AlephInfi/PRISTA/PRISTA design.docx

PRISTA design

1. Requirements were defined
  a. Course of one month, laying out structural considerations, integration limits, mission objectives.
  b. Mission objectives:
    i. Validate inter-board communication using UART and SPI (stacked) as well as RS485 (at distance).
    ii. Diagnose early issues on a low-cost board before higher-expense boards are manufactured.
  c. Mission statement:
    i. The primary mission is to catch, debug, and resolve issues arising from new board architectures before they are encountered in a time-sensitive project.
2. KiCAD design began after requirements definition.
  a. Requirements changed over time due to constraints and trade research encountered in PCB design
    i. Magnetometer switched to MMC5983MA, as the 5883 was not available. 5983 is the industrial version rated for higher temperatures and with SPI support.
