AlephInfi/PRISTA/main/jlcpcb/production_files/BOM-main.csv

Comment | Designator | Footprint | LCSC | Quantity
10 | R13 | R_0603_1608Metric | C22859 | 1
100 | R11,R12,R2,R3 | R_0603_1608Metric | C22775 | 4
100k | R1 | R_0603_1608Metric | C25803 | 1
100n | C10,C12,C14,C17,C19,C2,C20,C22,C23,C26,C27,C28,C29,C3,C30,C31,C35,C36,C38,C39,C4,C40,C42,C46,C5,C6,C9 | C_0603_1608Metric | C14663 | 27
10k | R10,R18,R19,R20,R4,R5,R9 | R_0603_1608Metric | C25804 | 7
10k | RN1 | R_Array_Convex_4x0603 | C29718 | 1
10n | C43 | C_0603_1608Metric | C57112 | 1
10p | C47,C48,C49,C50,C51,C52 | C_0603_1608Metric | C1634 | 6
10u | C24,C37,C41 | C_0603_1608Metric | C19702 | 3
10u 25V | C16 | C_0805_2012Metric | C15850 | 1
16MHz | U10,U11,U6 | Crystal_SMD_3225-4Pin_3.2x2.5mm | C13738 | 3
1k | R14,R15,R8 | R_0603_1608Metric | C21190 | 3
1u | C13,C25,C7,C8 | C_0603_1608Metric | C15849 | 4
2.2u | C44,C45 | C_0603_1608Metric | C23630 | 2
2.7k | R6,R7 | R_0603_1608Metric | C13167 | 2
22 | R21,R22,R23 | R_0603_1608Metric | C23345 | 3
22u | C18,C21 | C_0603_1608Metric | C59461 | 2
27n | L2 | L_0603_1608Metric | C12669 | 1
4.7k | R16,R17 | R_0603_1608Metric | C23162 | 2
4.7u | L1 | L_6.3x6.3_H3 | C128688 | 1
4.7u | C1,C11,C15 | C_0603_1608Metric | C19666 | 3
AO3401A | Q1 | SOT-23 | C15127 | 1
AP63203WU | U4 | TSOT-23-6 | C780769 | 1
BMI323 | U12 | BMI323_BOS | C5368700 | 1
LED red | D1,D2,D3 | LED_0805_2012Metric | C84256 | 3
LSM6DSL | U2 | LGA-14_3x2.5mm_P0.5mm_LayoutBorder3x4y | C126672 | 1
MMC5983MA | U3 | LGA-16_3x3mm_P0.5mm | C404329 | 1
Micro_SD_Card_Det1 | J1 | microSD_HC_Molex_47219-2001 | C164170 | 1
SP3485EN | U5,U9 | SOIC-8_3.9x4.9mm_P1.27mm | C8963 | 2
STM32F405RGTx | U1 | LQFP-64_10x10mm_P0.5mm | C15742 | 1
STM32G071CBT6 | U7,U8 | LQFP-48_7x7mm_P0.5mm | C432212 | 2
