AlephInfi/PRISTA/SW_Timing_Budgets.xlsx

Sheet: SW_Timing_Budgets
CTRL-F Payload 2026 · Software timing budget
Board 1 STM32F405 (LSM6DSL, MMC5983MA, microSD, RS-485) · Board 2 STM32G071 (BMI323, stacked) · Board 3 STM32G071 (MAX-M10S GPS, RS-485). Peripheral/pin assignments taken from the three .ioc files; change a cell here and every rate, DMA check and timeline downstream recomputes.
Legend: blue text = input you edit · yellow fill = key lever · black = formula · green = pulled from another sheet · status cells turn red/amber when a limit is broken.
1 · Global loop inputs
Target loop rate |  |  | 1000 | Hz | Requirement: ≥100 Hz minimum, 1 kHz target (one sample + analysis per sensor per cycle). Every per-cycle number scales from this.
Minimum loop rate |  |  | 100 | Hz | Stated requirement floor.
Loop period |  |  | 1000.0 | µs | Time available per cycle.
Max bus utilization allowed |  |  | 60.0% |  | Headroom for retries, jitter and growth. Buses above this turn red on Interface_Data_Rates.
Max CPU utilization allowed |  |  | 70.0% |  | Leave ≥30% for ISR jitter, logging stalls and future code.
Magnetometer ODR (MMC5983MA) |  |  | 1000 | Hz | 1 kHz needs continuous mode with BW=11 (0.5 ms measurement). BW=00 is ~8 ms → ≤100 Hz.
GPS navigation rate (MAX-M10S) |  |  | 10 | Hz | Default config (GPS+GAL+BDS B1I) is 3 Hz max; GPS+GAL allows 10 Hz; single-GNSS 18 Hz (MAX-M10S datasheet Tables 2–3).
SDIO kernel clock (PLL Q) |  |  | 48.000 | MHz | F405: PLLM 16, PLLN 192, PLLQ 4 from the 16 MHz HSE (as set in the fixed .ioc).
Loop target meets minimum? |  |  | OK
2 · Clock tree per MCU (edit SYSCLK and dividers; all bus/timer clocks follow)
Board | MCU | Clock source | HSE (MHz) | SYSCLK (MHz) | AHB ÷ | APB1 ÷ | APB2 ÷ | HCLK (MHz) | PCLK1 (MHz) | PCLK2 (MHz) | TIMCLK1 (MHz) | TIMCLK2 (MHz) | SYSCLK max | APB1 max | APB2 max | Status | Notes
B1 | STM32F405RG | HSE 16 MHz xtal | 16.000 | 16.000 | 1 | 1 | 1 | 16.000 | 16.000 | 16.000 | 16.000 | 16.000 | 168.000 | 42.000 | 84.000 | OK | As built: SYSCLK = HSE 16 MHz (PLL only feeds SDIO 48 MHz). For 168 MHz set SYSCLK 168, APB1 ÷4, APB2 ÷2 (PLLM16 N336 P2 Q7), then re-check SPI2 prescaler (LSM6DSL ≤10 MHz) below.
B2 | STM32G071CB | HSE 16 MHz xtal | 16.000 | 16.000 | 1 | 1 | 1 | 16.000 | 16.000 | 16.000 | 16.000 | 16.000 | 64.000 | 64.000 | 64.000 | OK | G0 has a single APB: APB2 column mirrors APB1. 64 MHz possible via PLL (M1 N8 R2 from 16 MHz).
B3 | STM32G071CB | HSE 16 MHz xtal | 16.000 | 16.000 | 1 | 1 | 1 | 16.000 | 16.000 | 16.000 | 16.000 | 16.000 | 64.000 | 64.000 | 64.000 | OK | Fixed .ioc sets HSE crystal mode (PF0+PF1).
3 · Peripheral allocation: which component uses which SPIx / I2Cx / UARTx / DMA / IRQ (edit Clock domain, Setting, Max)
ID | Board | Component | Function | Peripheral | Clock domain | Kernel clk (MHz) | Mode | Setting type | Setting | Bit clock / baud (Hz) | Baud error | Max allowed (Hz) | Status | Data pins | Control / IRQ pins | DMA RX (from §4) | DMA TX (from §4) | IRQ handlers | NVIC prio | Notes
B1-SPI2 | B1 | U2 LSM6DSL | 6-axis IMU | SPI2 | APB1 | 16.000 | Master, mode 3 | Prescaler | 2 | 8000000 |  | 10000000 | OK | PB13 SCK, PB14 MISO, PB15 MOSI | CS PB12 · INT1 PC6 (EXTI6) · INT2 PC7 | DMA1 Stream3 ch0 · Normal · High | DMA1 Stream4 ch0 · Normal · High | DMA1_Stream3, EXTI9_5, SPI2 (err) | 5 | .ioc: 8 Mbit/s. LSM6DSL fSCK max 10 MHz. At 168 MHz (APB1 42 MHz) use prescaler 8 → 5.25 MHz.
B1-I2C1 | B1 | U3 MMC5983MA | Magnetometer | I2C1 | APB1 | 16.000 | Master, Fast-mode | SCL | 400000 | 400000 |  | 400000 | OK | PB8 SCL, PB9 SDA (R6/R7 2.7k) | MAG_INT PC13 (EXTI13) | DMA1 Stream0 ch1 · Normal · Medium | DMA1 Stream6 ch1 · Normal · Low | I2C1_EV, I2C1_ER, DMA1_Stream0/6, EXTI15_10 | 5 | .ioc still I2C_Standard (100 kHz): change to Fast 400 kHz. F4 I2C needs PCLK1 ≥ 4 MHz for Fast-mode. Address 0x30.
B1-SPI1 | B1 | Stack J10/J11 → B2 U7 | Inter-board SPI | SPI1 | APB2 | 16.000 | Master, mode 0 | Prescaler | 8 | 2000000 |  | 4000000 | OK | PA5 SCK, PA6 MISO, PA7 MOSI | CS PB1 (GPIO) · B2_INT PC4 (EXTI4) | DMA2 Stream0 ch3 · Normal · High | DMA2 Stream5 ch3 · Normal · High | DMA2_Stream0/5, EXTI4 | 5 | Max = min(8 MHz SI ceiling for the ~37 mm stack path, B2 PCLK/4 conservative slave limit). Fixed .ioc: prescaler 8 → 2 Mbit/s, medium slew.
B1-USART1 | B1 | U5 SP3485 → cable → B3 | RS-485 half-duplex | USART1 | APB2 | 16.000 | Async 8N1, DE by GPIO | Baud | 1000000 | 1000000 | 0.00% | 1000000 | OK | PB6 TX, PB7 RX | DE/RE PB5 (RS485_MODE_SW) | DMA2 Stream2 ch4 · Circular · Very high | DMA2 Stream7 ch4 · Normal · Medium | USART1 (IDLE, TC), DMA2_Stream2/7 | 5 | F4 USART has no hardware DE: release DE in the TC interrupt (not on DMA-complete, which fires ~1 char early). Max = min(SP3485 10 Mbps, fPCLK/16).
B1-UART4 | B1 | Stack J10 pins 5/6 → B2 USART3 | Inter-board UART | UART4 | APB1 | 16.000 | Async 8N1 | Baud | 1000000 | 1000000 | 0.00% | 1000000 | OK | PA0 TX, PA1 RX (net pcMCU_TX/RX) | — | DMA1 Stream2 ch4 · Circular · Medium | DMA1 Stream4 ch4 · Normal · Low | UART4, DMA1_Stream2/4 | 6 | Netlist: PA0 → J10.5 → J9.5 → B2 PB8, i.e. TX→TX; works only because B2 USART3 has TX/RX swap enabled. UART4_TX DMA shares DMA1 Stream4 with SPI2_TX (see §4).
B1-SDIO | B1 | J1 microSD | Data logging | SDIO | SDIO | 48.000 | 4-bit, default speed | CLKDIV | 0 | 24000000 |  | 25000000 | OK | PC8–PC11 D0–D3, PC12 CK, PD2 CMD | RN1 10k pull-ups on DAT0–3 | DMA2 Stream3 ch4 · Periph flow ctrl · Very high | DMA2 Stream6 ch4 · Periph flow ctrl · Very high | SDIO, DMA2_Stream3/6 | 7 | SDIO_CK = 48 MHz/(CLKDIV+2). HAL inits at 400 kHz, then switch to CLKDIV 0 → 24 MHz (default-speed limit 25 MHz). Use FIFO + burst INC4 on the DMA streams.
B2-SPI1 | B2 | U7 ← B1 stack | Inter-board SPI | SPI1 | APB1 | 16.000 | Slave, mode 0 | Slave of | B1-SPI1 | 2000000 |  | 4000000 | OK | PB3 SCK, PB4 MISO, PB5 MOSI | B_CS PB6 (GPIO in) · B2_INT PB12 (out) | DMA1 Ch1 ← SPI1_RX · Normal · Very high | DMA1 Ch2 ← SPI1_TX · Normal · Very high | DMA1_Ch1 (RX), DMA1_Ch2_3 (TX), EXTI4_15 | 0 | Bit clock follows the B1-SPI1 master. CS is a plain GPIO (no hardware NSS): arm RX/TX DMA before B1 drops CS, then pulse B2_INT. See Pin_Map for the EXTI6 clash if CS uses EXTI.
B2-SPI2 | B2 | U12 BMI323 | 6-axis IMU | SPI2 | APB1 | 16.000 | Master, mode 0/3 | Prescaler | 2 | 8000000 |  | 10000000 | OK | PB13 SCK, PB14 MISO, PB15 MOSI | CS PA8 · INT1 PC6 · INT2 PA9 | DMA1 Ch3 ← SPI2_RX · Normal · High | DMA1 Ch4 ← SPI2_TX · Normal · High | DMA1_Ch2_3, DMA1_Ch4_5_6_7, EXTI4_15 | 1 | .ioc: prescaler 16 → 1 Mbit/s. Prescaler 2 → 8 MHz is within BMI323 10 MHz and cuts the read from ~120 µs to ~15 µs.
B2-USART3 | B2 | U7 ↔ B1 UART4 | Inter-board UART | USART3 | APB1 | 16.000 | Async 8N1, TX/RX swap ON | Baud | 1000000 | 1000000 | 0.00% | 1000000 | OK | PB8, PB9 (swapped) | — | DMA1 Ch5 ← USART3_RX · Circular · Medium | DMA1 Ch6 ← USART3_TX · Normal · Low | USART3_4_LPUART1, DMA1_Ch4_5_6_7 | 2 | Swap must stay enabled (see B1-UART4). MSB-first removed in the fixed .ioc.
B3-I2C1 | B3 | U13 MAX-M10S | GPS (DDC 0x42) | I2C1 | APB1 | 16.000 | Master, Fast-mode | SCL | 400000 | 400000 |  | 400000 | OK | PB8 SCL, PB9 SDA (R16/R17 4.7k) | GPS_INT PC13 · RST PC15 (OD) · LNA_EN PB3 | DMA1 Ch1 ← I2C1_RX · Normal · High | DMA1 Ch2 ← I2C1_TX · Normal · Low | I2C1, DMA1_Ch1, DMA1_Ch2_3 | 2 | .ioc TIMINGR 0x00503D58 = 100 kHz at 16 MHz. MAX-M10S datasheet lists I2C Fast-mode 400 kHz: regenerate TIMINGR for 400 kHz in CubeMX.
B3-USART1 | B3 | U9 SP3485 ↔ B1 | RS-485 half-duplex | USART1 | APB1 | 16.000 | Async 8N1, swap ON, DE by GPIO | Baud | 1000000 | 1000000 | 0.00% | 1000000 | OK | PB6, PB7 (swapped) | DE/RE PB5 | DMA1 Ch3 ← USART1_RX · Circular · Very high | DMA1 Ch4 ← USART1_TX · Normal · Medium | USART1, DMA1_Ch4_5_6_7 | 1 | G0 has hardware DE, but only on the USART1_DE pin; PB5 is a GPIO, so DE is software-driven (release in TC IRQ).
4 · DMA schedule: stream/channel per request, conflict and mapping checks, bandwidth (edit Use DMA?, Stream, Ch)
Key | Board | Alloc ID | Dir | Use DMA? | Controller | Stream / Ch # | Request (F4 ch# / G0 DMAMUX) | Mode | Priority | Txn ID (Interface_Data_Rates) | Bytes / transfer | Transfers / s | Bytes / s | Stream conflict | Mapping check | Summary (feeds §3) | Notes
B1-SPI2|RX | B1 | B1-SPI2 | RX | Y | DMA1 | 3 | 0 | Normal | High | T01 | 13 | 1000 | 13000 | OK | OK (RM0090) | DMA1 Stream3 ch0 · Normal · High
B1-SPI2|TX | B1 | B1-SPI2 | TX | Y | DMA1 | 4 | 0 | Normal | High | T01 | 13 | 1000 | 13000 | CONFLICT | OK (RM0090) | DMA1 Stream4 ch0 · Normal · High | Only stream for SPI2_TX on F405.
B1-I2C1|RX | B1 | B1-I2C1 | RX | Y | DMA1 | 0 | 1 | Normal | Medium | T02 | 10 | 1000 | 10000 | OK | OK (RM0090) | DMA1 Stream0 ch1 · Normal · Medium | HAL_I2C_Mem_Read_DMA: address/register phase is interrupt-driven, data phase by DMA.
B1-I2C1|TX | B1 | B1-I2C1 | TX | Y | DMA1 | 6 | 1 | Normal | Low | T03 | 3 | 1 | 3 | OK | OK (RM0090) | DMA1 Stream6 ch1 · Normal · Low
B1-UART4|RX | B1 | B1-UART4 | RX | Y | DMA1 | 2 | 4 | Circular | Medium | T07 | 22 | 1000 | 22000 | OK | OK (RM0090) | DMA1 Stream2 ch4 · Circular · Medium | Circular RX + IDLE-line interrupt = frame-agnostic receive.
B1-UART4|TX | B1 | B1-UART4 | TX | Y | DMA1 | 4 | 4 | Normal | Low | T06 | 14 | 1000 | 14000 | CONFLICT | OK (RM0090) | DMA1 Stream4 ch4 · Normal · Low | CONFLICT with SPI2_TX (only legal stream for both). Fix: set Use DMA? = N here and send UART4 frames by TXE interrupt (8–14 B), or time-share Stream4 by re-programming CHSEL between transfers.
B1-SPI1|RX | B1 | B1-SPI1 | RX | Y | DMA2 | 0 | 3 | Normal | High | T04 | 32 | 1000 | 32000 | OK | OK (RM0090) | DMA2 Stream0 ch3 · Normal · High
B1-SPI1|TX | B1 | B1-SPI1 | TX | Y | DMA2 | 5 | 3 | Normal | High | T04 | 32 | 1000 | 32000 | OK | OK (RM0090) | DMA2 Stream5 ch3 · Normal · High | Stream5 chosen so SDIO can keep Stream3.
B1-USART1|RX | B1 | B1-USART1 | RX | Y | DMA2 | 2 | 4 | Circular | Very high | T09 | 30 | 1000 | 30000 | OK | OK (RM0090) | DMA2 Stream2 ch4 · Circular · Very high | Receives B3 frames; IDLE interrupt marks frame end.
B1-USART1|TX | B1 | B1-USART1 | TX | Y | DMA2 | 7 | 4 | Normal | Medium | T08 | 14 | 1000 | 14000 | OK | OK (RM0090) | DMA2 Stream7 ch4 · Normal · Medium
B1-SDIO|RX | B1 | B1-SDIO | RX | Y | DMA2 | 3 | 4 | Periph flow ctrl | Very high | T13 | 520 | 103.03125 | 53576.25 | OK | OK (RM0090) | DMA2 Stream3 ch4 · Periph flow ctrl · Very high | SDIO needs FIFO mode, burst INC4, peripheral flow control.
B1-SDIO|TX | B1 | B1-SDIO | TX | Y | DMA2 | 6 | 4 | Periph flow ctrl | Very high | T13 | 520 | 103.03125 | 53576.25 | OK | OK (RM0090) | DMA2 Stream6 ch4 · Periph flow ctrl · Very high
B2-SPI1|RX | B2 | B2-SPI1 | RX | Y | DMA1 | 1 | SPI1_RX | Normal | Very high | T04 | 32 | 1000 | 32000 | OK | OK (DMAMUX) | DMA1 Ch1 ← SPI1_RX · Normal · Very high | Slave: must be armed before CS falls.
B2-SPI1|TX | B2 | B2-SPI1 | TX | Y | DMA1 | 2 | SPI1_TX | Normal | Very high | T04 | 32 | 1000 | 32000 | OK | OK (DMAMUX) | DMA1 Ch2 ← SPI1_TX · Normal · Very high
B2-SPI2|RX | B2 | B2-SPI2 | RX | Y | DMA1 | 3 | SPI2_RX | Normal | High | T05 | 14 | 1000 | 14000 | OK | OK (DMAMUX) | DMA1 Ch3 ← SPI2_RX · Normal · High
B2-SPI2|TX | B2 | B2-SPI2 | TX | Y | DMA1 | 4 | SPI2_TX | Normal | High | T05 | 14 | 1000 | 14000 | OK | OK (DMAMUX) | DMA1 Ch4 ← SPI2_TX · Normal · High
B2-USART3|RX | B2 | B2-USART3 | RX | Y | DMA1 | 5 | USART3_RX | Circular | Medium | T06 | 14 | 1000 | 14000 | OK | OK (DMAMUX) | DMA1 Ch5 ← USART3_RX · Circular · Medium
B2-USART3|TX | B2 | B2-USART3 | TX | Y | DMA1 | 6 | USART3_TX | Normal | Low | T07 | 22 | 1000 | 22000 | OK | OK (DMAMUX) | DMA1 Ch6 ← USART3_TX · Normal · Low
B3-I2C1|RX | B3 | B3-I2C1 | RX | Y | DMA1 | 1 | I2C1_RX | Normal | High | T12 | 103 | 10 | 1030 | OK | OK (DMAMUX) | DMA1 Ch1 ← I2C1_RX · Normal · High
B3-I2C1|TX | B3 | B3-I2C1 | TX | Y | DMA1 | 2 | I2C1_TX | Normal | Low | T11 | 5 | 40 | 200 | OK | OK (DMAMUX) | DMA1 Ch2 ← I2C1_TX · Normal · Low
B3-USART1|RX | B3 | B3-USART1 | RX | Y | DMA1 | 3 | USART1_RX | Circular | Very high | T08 | 14 | 1000 | 14000 | OK | OK (DMAMUX) | DMA1 Ch3 ← USART1_RX · Circular · Very high
B3-USART1|TX | B3 | B3-USART1 | TX | Y | DMA1 | 4 | USART1_TX | Normal | Medium | T09 | 30 | 1000 | 30000 | OK | OK (DMAMUX) | DMA1 Ch4 ← USART1_TX · Normal · Medium
Board | Controller | Streams in use | Conflicts | Bytes / s | Status
B1 | DMA1 | 6 | 1 | 72003 | CONFLICT
B1 | DMA2 | 6 | 0 | 215152.5 | OK
B2 | DMA1 | 6 | 0 | 128000 | OK
B3 | DMA1 | 4 | 0 | 45230 | OK
F405 DMA request map used by the Mapping check (RM0090 Tables 42–43, subset). Verify in CubeMX before relying on it.
Request | Controller | Stream | Channel
SPI1_RX | DMA2 | 0 | 3
SPI1_RX | DMA2 | 2 | 3
SPI1_TX | DMA2 | 3 | 3
SPI1_TX | DMA2 | 5 | 3
SPI2_RX | DMA1 | 3 | 0
SPI2_TX | DMA1 | 4 | 0
I2C1_RX | DMA1 | 0 | 1
I2C1_RX | DMA1 | 5 | 1
I2C1_TX | DMA1 | 6 | 1
I2C1_TX | DMA1 | 7 | 1
USART1_RX | DMA2 | 2 | 4
USART1_RX | DMA2 | 5 | 4
USART1_TX | DMA2 | 7 | 4
UART4_RX | DMA1 | 2 | 4
UART4_TX | DMA1 | 4 | 4
SDIO_RX | DMA2 | 3 | 4
SDIO_RX | DMA2 | 6 | 4
SDIO_TX | DMA2 | 3 | 4
SDIO_TX | DMA2 | 6 | 4
5 · Timer allocation (TIMx): edit target tick; PSC/ARR and rates follow the clock tree and loop rate
Board | Timer | Clock domain | Timer clk (MHz) | Target tick (Hz) | PSC | Actual tick (Hz) | ARR | Update rate (Hz) | Wrap / period (s) | Counter bits | Fits? | Purpose | Pin / channel | Notes
B1 | TIM6 | APB1 | 16.000 | 1000000 | 15 | 1000000 | 999 | 1000.000 | 0.001000 | 16 | OK | Control-loop tick → starts sensor DMA | internal | ARR follows LoopHz. Update IRQ (TIM6_DAC) wakes the sensor task.
B1 | TIM2 | APB1 | 16.000 | 1000000 | 15 | 1000000 | 4294967295 | 0.0002328306437 | 4294.967296 | 32 | OK | 1 µs free-running timestamp | internal | Wraps every ~71.6 min; use for log timestamps and inter-board sync.
B1 | TIM7 | APB1 | 16.000 | 1000000 | 15 | 1000000 | 999 | 1000.000 | 0.001000 | 16 | OK | HAL timebase (FreeRTOS owns SysTick) | internal | CubeMX: SYS → Timebase source = TIM7 when FreeRTOS is enabled.
B2 | TIM2 | APB1 | 16.000 | 1000000 | 15 | 1000000 | 4294967295 | 0.0002328306437 | 4294.967296 | 32 | OK | 1 µs timestamp for BMI323 samples | internal | Re-zeroed from B1 time in each stack frame.
B2 | TIM6 | APB1 | 16.000 | 1000000 | 15 | 1000000 | 1999 | 500.000 | 0.002000 | 16 | OK | Stack link watchdog (2 loop periods) | internal | If B1 has not clocked a frame in 2 periods, re-arm SPI1 DMA.
B3 | TIM3 | APB1 | 16.000 | 1000000 | 15 | 1000000 | 65535 | 15.259 | 0.065536 | 16 | OK | GPS 1PPS input capture (TIMEPULSE) | PB4 = TIM3_CH1 (AF1) | 16-bit at 1 µs wraps every 65.5 ms: count update IRQs to extend to 32 bits. .ioc has PB4 as plain GPIO input: change to TIM3_CH1.
B3 | TIM2 | APB1 | 16.000 | 1000000 | 15 | 1000000 | 4294967295 | 0.0002328306437 | 4294.967296 | 32 | OK | 1 µs timestamp | internal
B3 | TIM6 | APB1 | 16.000 | 1000000 | 15 | 1000000 | 999 | 1000.000 | 0.001000 | 16 | OK | RS-485 response timeout (1 loop period) | internal | Drop DE and return to RX if a frame is incomplete.
6 · Per-cycle task timeline (worst cycle = every periodic job lands in the same cycle; DMA lets bus and CPU overlap, so the serial sum is an upper bound)
Board | # | Task | Bus txn ID | Trigger | Bus µs / occurrence | CPU cycles / occurrence | CPU µs / occurrence | Occurrences / cycle | Worst-cycle µs | Serial start µs | Serial end µs | Avg CPU µs / cycle | Avg bus µs / cycle | Notes
B1 | 1 | Loop tick ISR → kick sensor DMA |  | TIM6 update | 0.0 | 300 | 18.8 | 1.000 | 18.8 | 0.0 | 18.8 | 18.8 | 0.0
B1 | 2 | LSM6DSL read (SPI2 DMA) | T01 | tick / INT1 DRDY | 14.0 | 400 | 25.0 | 1.000 | 39.0 | 18.8 | 57.8 | 25.0 | 14.0
B1 | 3 | MMC5983MA read (I2C1 DMA) | T02 | MAG_INT | 237.5 | 600 | 37.5 | 1.000 | 275.0 | 57.8 | 332.8 | 37.5 | 237.5
B1 | 4 | MMC5983MA SET/RESET write | T03 | 1 Hz | 77.5 | 300 | 18.8 | 0.001 | 96.2 | 332.8 | 429.0 | 0.01875 | 0.1
B1 | 5 | Stack SPI1 exchange with B2 | T04 | B2_INT ready | 138.0 | 500 | 31.2 | 1.000 | 169.2 | 429.0 | 598.2 | 31.2 | 138.0
B1 | 6 | UART4 frame to B2 | T06 | loop | 140.0 | 300 | 18.8 | 1.000 | 158.8 | 598.2 | 757.0 | 18.8 | 140.0
B1 | 7 | RS-485 poll to B3 (DE high) | T08 | loop | 160.0 | 400 | 25.0 | 1.000 | 185.0 | 757.0 | 942.0 | 25.0 | 160.0
B1 | 8 | RS-485 status from B3 (RX DMA + IDLE) | T09 | USART1 IDLE | 320.0 | 600 | 37.5 | 1.000 | 357.5 | 942.0 | 1299.5 | 37.5 | 320.0
B1 | 9 | RS-485 GPS summary from B3 | T10 | USART1 IDLE | 560.0 | 800 | 50.0 | 0.010 | 610.0 | 1299.5 | 1909.5 | 0.5 | 5.6
B1 | 10 | Sensor fusion / analysis (AHRS / EKF) |  | all reads done | 0.0 | 10000 | 625.0 | 1.000 | 625.0 | 1909.5 | 2534.5 | 625.0 | 0.0 | Estimate: Madgwick ≈ 2–5k cycles, small EKF ≈ 10–30k cycles on M4F with FPU. Measure with DWT->CYCCNT and replace.
B1 | 11 | Frame pack + CRC + append to log buffer |  | loop | 0.0 | 2000 | 125.0 | 1.000 | 125.0 | 2534.5 | 2659.5 | 125.0 | 0.0
B1 | 12 | SD block write (FatFs, SDIO DMA) | T13 | buffer half full | 345.3 | 5000 | 312.5 | 0.103 | 657.8 | 2659.5 | 3317.3 | 32.2 | 35.6 | Run in a low-priority task so a card stall never blocks the loop.
B2 | 1 | BMI323 read (SPI2 DMA) | T05 | INT1 DRDY | 15.0 | 500 | 31.2 | 1.000 | 46.2 | 0.0 | 46.2 | 31.2 | 15.0
B2 | 2 | Pack stack frame (scale, timestamp, CRC) |  | after read | 0.0 | 1500 | 93.8 | 1.000 | 93.8 | 46.2 | 140.0 | 93.8 | 0.0
B2 | 3 | Stack SPI1 slave exchange | T04 | B_CS from B1 | 138.0 | 400 | 25.0 | 1.000 | 163.0 | 140.0 | 303.0 | 25.0 | 138.0
B2 | 4 | USART3 frame to B1 | T07 | loop | 220.0 | 300 | 18.8 | 1.000 | 238.8 | 303.0 | 541.8 | 18.8 | 220.0
B3 | 1 | RS-485 poll from B1 (RX) | T08 | USART1 IDLE | 160.0 | 600 | 37.5 | 1.000 | 197.5 | 0.0 | 197.5 | 37.5 | 160.0
B3 | 2 | RS-485 status reply (DE high) | T09 | after poll | 320.0 | 500 | 31.2 | 1.000 | 351.2 | 197.5 | 548.8 | 31.2 | 320.0
B3 | 3 | GPS bytes-available poll (I2C1) | T11 | 4× nav rate | 125.0 | 400 | 25.0 | 0.040 | 150.0 | 548.8 | 698.8 | 1.0 | 5.0
B3 | 4 | GPS NAV-PVT read (I2C1 DMA) | T12 | nav rate | 2330.0 | 600 | 37.5 | 0.010 | 2367.5 | 698.8 | 3066.2 | 0.4 | 23.3
B3 | 5 | UBX parse + checksum + summary |  | after read | 0.0 | 4000 | 250.0 | 0.010 | 250.0 | 3066.2 | 3316.2 | 2.5 | 0.0
B3 | 6 | RS-485 GPS summary (DE high) | T10 | nav rate | 560.0 | 500 | 31.2 | 0.010 | 591.2 | 3316.2 | 3907.5 | 0.3 | 5.6
Board | Worst-cycle CPU µs (serial) | Busiest loop bus, worst cycle µs | Loop period µs | Worst cycle fits? | Avg CPU µs / cycle | CPU util (tasks) | Allowed | Status | Max loop rate, CPU-bound (Hz) | SYSCLK needed (MHz) | Notes
B1 | 1325.0 | 1040.0 | 1000.0 | OVER | 976.5 | 97.6% | 70.0% | OVER | 716.8708268 | 22.3 | DMA runs buses in parallel with the CPU, so a cycle fits if both the CPU critical path and the busiest loop-synchronous bus fit. Start/End columns above are a no-overlap serial view. Task CPU only: CPU_Load adds interrupt overhead.
B2 | 168.8 | 220.0 | 1000.0 | OK | 168.8 | 16.9% | 70.0% | OK | 4148.148148 | 3.9 | DMA runs buses in parallel with the CPU, so a cycle fits if both the CPU critical path and the busiest loop-synchronous bus fit. Start/End columns above are a no-overlap serial view. Task CPU only: CPU_Load adds interrupt overhead.
B3 | 412.5 | 1040.0 | 1000.0 | OVER | 72.9 | 7.3% | 70.0% | OK | 9597.257926 | 1.7 | DMA runs buses in parallel with the CPU, so a cycle fits if both the CPU critical path and the busiest loop-synchronous bus fit. Start/End columns above are a no-overlap serial view. Task CPU only: CPU_Load adds interrupt overhead.

Sheet: Interface_Data_Rates
Interface data rates · per transaction and per bus
Bit clocks come from the allocation table on SW_Timing_Budgets (change a prescaler/baud there). Edit payload/overhead/occurrence here. Times include protocol bit overhead.
Legend: blue text = input you edit · yellow fill = key lever · black = formula · green = pulled from another sheet · status cells turn red/amber when a limit is broken.
1 · Wire-format constants
Protocol | Wire clocks per byte | Basis
SPI | 8 | 8 SCK edges per byte, full duplex
I2C | 9 | 8 data bits + ACK
UART | 10 | 8N1: start + 8 data + stop
SDIO4 | 2 | 4-bit bus: 2 clocks per byte
2 · Transactions (one row per message type)
ID | Transaction | Bus ID | Alloc ID | Protocol | Bit clock / baud (Hz) | Payload bytes | Overhead bytes | Total bytes | Clocks / byte | Fixed bits | Fixed µs | Txn time (µs) | Occurrences / loop | Rate (Hz) | Bus busy (µs/s) | Bus util | Payload (B/s) | Wire (bit/s) | Notes
T01 | LSM6DSL burst read OUTX_L_G…OUTZ_H_XL (gyro + accel) | B1-SPI2 | B1-SPI2 | SPI | 8000000 | 12 | 1 | 13 | 8 | 0 | 1.0 | 14.0 | 1.000 | 1000.0 | 14000 | 1.4% | 12000 | 104000 | 1 address byte (0x22 | 0x80, IF_INC auto-increment). +2 B for temperature. Fixed µs = CS setup/hold + DMA start.
T02 | MMC5983MA read Xout0…XYZout2 (3 × 18-bit) | B1-I2C1 | B1-I2C1 | I2C | 400000 | 7 | 3 | 10 | 9 | 3 | 5.0 | 237.5 | 1.000 | 1000.0 | 237500 | 23.8% | 7000 | 93000 | Overhead = addr+W, reg 0x00, addr+R. Fixed bits = START, repeated START, STOP. Fixed µs = HAL I2C state machine (estimate).
T03 | MMC5983MA control write (SET/RESET, 1 Hz) | B1-I2C1 | B1-I2C1 | I2C | 400000 | 1 | 2 | 3 | 9 | 2 | 5.0 | 77.5 | 0.001 | 1.0 | 77.5 | 0.00775% | 1 | 29 | Writes Internal Control 0 (0x09) once a second. Set occurrences to 0 if you use the automatic periodic SET (En_prd_set).
T04 | B1 ↔ B2 stack SPI frame (B2 IMU + status + seq + CRC16) | B1-SPI1 | B1-SPI1 | SPI | 2000000 | 32 | 0 | 32 | 8 | 0 | 10.0 | 138.0 | 1.000 | 1000.0 | 138000 | 13.8% | 32000 | 256000 | Full duplex: 32 B each way in one transfer. 10 µs = CS-to-first-SCK guard so the B2 slave DMA is armed.
T05 | BMI323 read ACC_DATA_X…GYR_DATA_Z | B2-SPI2 | B2-SPI2 | SPI | 8000000 | 12 | 2 | 14 | 8 | 0 | 1.0 | 15.0 | 1.000 | 1000.0 | 15000 | 1.5% | 12000 | 112000 | BMI323 SPI read = address byte + 1 dummy byte, then 16-bit words.
T06 | B1 → B2 UART4 frame (time sync / command) | B1-UART4 TX | B1-UART4 | UART | 1000000 | 8 | 6 | 14 | 10 | 0 | 0.0 | 140.0 | 1.000 | 1000.0 | 140000 | 14.0% | 8000 | 140000 | Overhead = 2 sync + length + seq + CRC16. Full-duplex UART: each direction is its own bus.
T07 | B2 → B1 USART3 frame (status / ack) | B2-USART3 TX | B2-USART3 | UART | 1000000 | 16 | 6 | 22 | 10 | 0 | 0.0 | 220.0 | 1.000 | 1000.0 | 220000 | 22.0% | 16000 | 220000
T08 | B1 → B3 RS-485 poll / command | RS485 | B1-USART1 | UART | 1000000 | 8 | 6 | 14 | 10 | 0 | 20.0 | 160.0 | 1.000 | 1000.0 | 160000 | 16.0% | 8000 | 140000 | Half-duplex: all RS-485 rows share one bus. Fixed µs = DE switch + responder turnaround.
T09 | B3 → B1 RS-485 status frame | RS485 | B3-USART1 | UART | 1000000 | 24 | 6 | 30 | 10 | 0 | 20.0 | 320.0 | 1.000 | 1000.0 | 320000 | 32.0% | 24000 | 300000
T10 | B3 → B1 RS-485 GPS summary (pos / vel / time / fix) | RS485 | B3-USART1 | UART | 1000000 | 48 | 6 | 54 | 10 | 0 | 20.0 | 560.0 | 0.010 | 10.0 | 5600 | 0.6% | 480 | 5400
T11 | MAX-M10S bytes-available read (0xFD/0xFE) | B3-I2C1 | B3-I2C1 | I2C | 400000 | 2 | 3 | 5 | 9 | 3 | 5.0 | 125.0 | 0.040 | 40.0 | 5000 | 0.5% | 80 | 1920 | Polled at 4× nav rate. Using GPS_INT (TX-ready on PC13) instead drops this to 0.
T12 | MAX-M10S UBX-NAV-PVT read from 0xFF stream | B3-I2C1 | B3-I2C1 | I2C | 400000 | 100 | 3 | 103 | 9 | 3 | 5.0 | 2330.0 | 0.010 | 10.0 | 23300 | 2.3% | 1000 | 9300 | NAV-PVT = 92 B payload + 8 B UBX header/checksum.
T13 | microSD 512 B block write (SDIO DMA) | B1-SDIO | B1-SDIO | SDIO4 | 24000000 | 512 | 8 | 520 | 2 | 48 | 300.0 | 345.3 | 0.103 | 103.0 | 35580.125 | 3.6% | 52752 | 112098 | Overhead = CRC16 per data line; 48 bits = command. Fixed µs = typical card programming busy. Cards can stall 100–500 ms: buffer sized on Memory_Logging.
3 · Bus utilization summary
Bus ID | Board | Busy (µs/s) | Utilization | Allowed | Status | Worst-cycle busy (µs) | Must finish within one loop? | Fits? | Max loop rate at allowed util (Hz) | Notes
B1-SPI2 | B1 | 14000 | 1.4% | 60.0% | OK | 14.0 | Y | OK | 42857.14286
B1-I2C1 | B1 | 237577.5 | 23.8% | 60.0% | OK | 315.0 | Y | OK | 2525.491682 | At 100 kHz (current .ioc) this bus alone caps the loop well below 1 kHz.
B1-SPI1 | B1 | 138000 | 13.8% | 60.0% | OK | 138.0 | Y | OK | 4347.826087
B1-UART4 TX | B1 | 140000 | 14.0% | 60.0% | OK | 140.0 | Y | OK | 4285.714286
B2-USART3 TX | B2 | 220000 | 22.0% | 60.0% | OK | 220.0 | Y | OK | 2727.272727
RS485 | B1+B3 | 485600 | 48.6% | 60.0% | OK | 1040.0 | Y | OVER | 1235.584843 | Half-duplex: poll + status + GPS summary share one pair. In the cycle where the GPS frame lands, poll+status+GPS exceed 1 ms at 1 Mbaud: send the GPS summary instead of (not after) the status frame, or split it. |  |  |  | Solve by setting 1 sample every few loops
B2-SPI2 | B2 | 15000 | 1.5% | 60.0% | OK | 15.0 | Y | OK | 40000
B3-I2C1 | B3 | 28300 | 2.8% | 60.0% | OK | 2455.0 | N | async | 21201.41343 | GPS-rate traffic: a 2.3 ms DMA read may span loop ticks. "Max loop rate" overstates headroom (not loop-scaled).
B1-SDIO | B1 | 35580.125 | 3.6% | 60.0% | OK | 345.3 | N | async | 16863.34716 | Runs in a background task from the log buffer.

Sheet: Power_Budget
Power budget · per component, 3V3 rail, buck, battery
Currents are datasheet typicals/maxima or labelled estimates (see Basis). MCU current scales with SYSCLK from the clock tree; SD/RS-485/pull-up currents scale with bus utilization.
Legend: blue text = input you edit · yellow fill = key lever · black = formula · green = pulled from another sheet · status cells turn red/amber when a limit is broken.
1 · Assumptions
3V3 rail voltage |  |  | 3.30 |  |  | V | AP63203 fixed 3.3 V output.
Battery V min / nom / max (D, E, F) |  |  | 6.0 | 7.4 | 8.4 | V | 2S Li-ion/LiPo: 3.0 V/cell cutoff.
Buck η light / typ / heavy (D, E, F) |  |  | 70.0% | 85.0% | 87.0% |  | AP63203 datasheet efficiency curves at 7.4 V in (estimate; PFM at light load).
Buck quiescent current |  |  | 0.022 |  |  | mA | AP63203 Iq ≈ 22 µA (non-switching).
Buck rating |  |  | 2000 |  |  | mA | AP63203 continuous output.
Q1 AO3401A Rds(on) |  |  | 0.060 |  |  | Ω | At Vgs = −4.5 V (battery 6–8.4 V gives ≥ this drive).
Q1 rating |  |  | 4000 |  |  | mA | AO3401A continuous drain current.
Battery capacity / usable fraction (D, E) |  |  | 2000 | 80.0% |  | mAh | Assumption: enter your pack. Usable fraction in G13.
LED Vf / series R (D, E) |  |  | 1.90 | 1000 |  | V | Red 0805 LED (C84256) ≈ 1.9 V; R8/R14/R15 = 1 kΩ .
LED on-duty (typ) |  |  | 50.0% |  |  |  | Blinking heartbeat.
I2C pull-ups B1 / B3 (D, E) |  |  | 2700 | 4700 |  | Ω | R6/R7 2.7k (B1), R16/R17 4.7k (B3, G16).
SD idle / active write current (D, E) |  |  | 0.50 | 80.00 |  | mA | Card-dependent: idle 0.2–1 mA; writing 50–100 mA ; peaks to ~200 mA.
RS-485 Vod (D) / DC load Ω (E) |  |  | 2.00 | 120 |  | V | Load : 120 Ω = one terminator, 60 Ω = both ends, 12 000 Ω = unterminated (receiver 1 UL).
SP3485 quiescent current |  |  | 0.80 |  |  | mA | Estimate (receiver on, driver idle). Check Exar/MaxLinear SP3485 ICC.
F405 run current: base (D) + k (E) · SYSCLK |  |  | 2.00 | 0.500 |  | mA | k mA/MHz. Fits DS8626 run-from-flash, peripherals on: ≈10 mA @16 MHz, ≈86 mA @168 MHz. Estimate.
G071 run current: base (D) + k (E) · SYSCLK |  |  | 0.50 | 0.100 |  | mA | k . ≈100 µA/MHz run from flash (STM32G071 DS). Estimate.
MCU min (D) / max (E) factor vs typ |  |  | 0.50 | 1.40 |  |  | Min = sleep between DMA events; max = 85 °C, all peripherals active.
2 · Component currents (3V3 rail)
Board | Ref | Part | Rail (V) | I min (mA) | I typ (mA) | I max (mA) | I peak (mA) | P min (mW) | P typ (mW) | P max (mW) | P peak (mW) | Basis / source
B1 | U1 | STM32F405RG (+HSE xtal) | 3.30 | 1.00 | 2.00 | 2.80 | 2.80 | 3.3 | 6.6 | 9.2 | 9.2 | Scales with SYSCLK on SW_Timing_Budgets. DS8626 Tables 20–23 (estimate fit).
B1 | U2 | LSM6DSL | 3.30 | 0.003 | 0.90 | 1.25 | 1.25 | 0.0099 | 3.0 | 4.1 | 4.1 | Datasheet: 0.9 mA combo high-performance; 3 µA power-down. Max is estimate at 6.66 kHz.
B1 | U3 | MMC5983MA | 3.30 | 0.001 | 0.45 | 1.00 | 1.00 | 0.0033 | 1.5 | 3.3 | 3.3 | Estimate at high continuous rate; SET/RESET pulses come from the CAP reservoir. Verify against datasheet current vs BW.
B1 | J1 | microSD card | 3.30 | 0.50 | 3.35 | 80.00 | 200.00 | 1.6 | 11.0 | 264.0 | 660.0 | Typ = idle + write duty (SDIO bus util) × active current. Peak 200 mA during program/erase.
B1 | U5 | SP3485 (RS-485) | 3.30 | 0.80 | 4.85 | 17.47 | 17.47 | 2.6 | 16.0 | 57.6 | 57.6 | Driver current only while this end transmits (≈ half the RS-485 bus time).
B1 | R6/R7 | I2C pull-ups 2.7k | 3.30 | 0.00 | 0.29 | 2.44 | 2.44 | 0.0 | 1.0 | 8.1 | 8.1 | Current flows only while a line is low (≈50% of busy time).
B1 | RN1 | SD DAT pull-ups 4×10k | 3.30 | 0.00 | 0.02 | 1.32 | 1.32 | 0.0 | 0.1 | 4.4 | 4.4
B1 | D1 | LED red + 1k | 3.30 | 0.00 | 0.70 | 1.40 | 1.40 | 0.0 | 2.3 | 4.6 | 4.6 | (3.3 − Vf)/R
B2 | U7 | STM32G071CB (+HSE xtal) | 3.30 | 1.05 | 2.10 | 2.94 | 2.94 | 3.5 | 6.9 | 9.7 | 9.7 | Scales with SYSCLK.
B2 | U12 | BMI323 | 3.30 | 0.004 | 0.79 | 1.00 | 1.00 | 0.0132 | 2.6 | 3.3 | 3.3 | Datasheet: ≈790 µA accel+gyro high-performance. Suspend few µA.
B2 | D2 | LED red + 1k | 3.30 | 0.00 | 0.70 | 1.40 | 1.40 | 0.0 | 2.3 | 4.6 | 4.6
B3 | U8 | STM32G071CB (+HSE xtal) | 3.30 | 1.05 | 2.10 | 2.94 | 2.94 | 3.5 | 6.9 | 9.7 | 9.7 | Scales with SYSCLK.
B3 | U13 | MAX-M10S GNSS | 3.30 | 0.05 | 11.80 | 15.30 | 100.00 | 0.2 | 38.9 | 50.5 | 330.0 | MAX-M10S DS Table 15 @3.0 V: tracking 9.5 mA + VIO 2.3 mA (default GNSS); acquisition up to 13 + 2.3 mA; inrush up to 100 mA. Min = software standby.
B3 | AE1 | Active antenna LNA (via VCC_RF) | 3.30 | 0.00 | 10.00 | 20.00 | 20.00 | 0.0 | 33.0 | 66.0 | 66.0 | Assumption: depends on the antenna you buy (typ. 5–20 mA). MAX-M10S VCC_RF recommended ≤ 50 mA. Min = LNA_EN off.
B3 | U9 | SP3485 (RS-485) | 3.30 | 0.80 | 4.85 | 17.47 | 17.47 | 2.6 | 16.0 | 57.6 | 57.6
B3 | R16/R17 | I2C pull-ups 4.7k | 3.30 | 0.00 | 0.02 | 1.40 | 1.40 | 0.0 | 0.1 | 4.6 | 4.6
B3 | D3 | LED red + 1k | 3.30 | 0.00 | 0.70 | 1.40 | 1.40 | 0.0 | 2.3 | 4.6 | 4.6
3V3 rail total |  |  | 3.30 | 5.25 | 45.61 | 171.53 | 376.23 | 17.3 | 150.5 | 566.1 | 1241.6 | Peak column sums coincident worst-case peaks (conservative).
Per-board 3V3 load (B2 and B3 are fed from B1 through the stack header / RS-485 cable)
Board | I min (mA) | I typ (mA) | I max (mA) | I peak (mA)
B1 | 2.30 | 12.56 | 107.68 | 227.68
B2 | 1.05 | 3.59 | 5.34 | 5.34
B3 | 1.90 | 29.47 | 58.51 | 143.21
3 · Buck converter and battery (input current = Pout / (η · Vbat) + Iq; Q1 loss = I² · Rds)
Load case | 3V3 load (mA) | Pout (mW) | η | Buck loss (mW) | I bat @ min V (mA) | I bat @ nom V (mA) | I bat @ max V (mA) | Q1 loss @ min V (mW) | Battery power @ nom (mW) | Runtime @ nom (h) | Notes
Min | 5.25 | 17.3 | 70.0% | 7.4 | 4.15 | 3.37 | 2.97 | 0.001033421144 | 24.9 | 474.9 | Sleep between events.
Typical | 45.61 | 150.5 | 85.0% | 26.6 | 29.54 | 23.95 | 21.10 | 0.05 | 177.3 | 66.8 | Runtime estimate uses this row.
Max | 171.53 | 566.1 | 87.0% | 84.6 | 108.46 | 87.95 | 77.48 | 0.71 | 650.8 | 18.2 | All sensors max, RS-485 transmitting into the load.
Peak | 376.23 | 1241.6 | 87.0% | 185.5 | 237.87 | 192.87 | 169.91 | 3.39 | 1427.2 | 8.3 | Coincident peaks (SD program + GPS inrush). Use for buck/FET sizing.
Check | Value | Limit | Margin | Status
Buck output: 3V3 peak load (mA) vs rating | 376.2320331 | 2000 | 81.2% | OK
Q1: peak battery current (mA) vs rating | 237.869837 | 4000 | 94.1% | OK
GPS active antenna current (mA) vs VCC_RF 50 mA | 20 | 50 | 60.0% | OK

Sheet: CPU_Load
CPU load · interrupt overhead, task load, NVIC / FreeRTOS priority rules
Interrupt rates follow the transaction rates on Interface_Data_Rates. Cycles per ISR are estimates (HAL handlers are heavy); measure with DWT->CYCCNT and replace.
Legend: blue text = input you edit · yellow fill = key lever · black = formula · green = pulled from another sheet · status cells turn red/amber when a limit is broken.
1 · RTOS settings (Board 1 runs FreeRTOS per .ioc)
configLIBRARY_MAX_SYSCALL_INTERRUPT_PRIORITY |  |  | 5 |  | ISRs that call FreeRTOS ...FromISR() APIs must have numeric priority ≥ this (lower urgency).
FreeRTOS tick rate |  |  | 1000 | Hz | configTICK_RATE_HZ.
Context-switch cost |  |  | 200 | cycles | Cortex-M4 with FPU lazy stacking ≈ 100–300 cycles.
2 · Interrupt sources
Board | IRQ handler | Source | Events / s | Cycles / ISR | CPU µs / s | CPU % | NVIC prio | Calls RTOS API? | Priority check | Notes
B1 | TIM6_DAC_IRQHandler | Loop tick | 1000 | 150 | 9375 | 0.9% | 6 | Y | OK
B1 | DMA1_Stream3_IRQHandler | SPI2 RX complete (LSM6DSL) | 1000 | 250 | 15625 | 1.6% | 5 | Y | OK
B1 | EXTI9_5_IRQHandler | LSM6DSL INT1 data-ready | 1000 | 120 | 7500 | 0.8% | 6 | Y | OK | Skip if the loop tick starts the read instead of DRDY.
B1 | DMA1_Stream0_IRQHandler | I2C1 RX complete (MMC5983MA) | 1000 | 250 | 15625 | 1.6% | 5 | Y | OK
B1 | I2C1_EV_IRQHandler | I2C address/register phases (≈4 per txn) | 4004 | 150 | 37537.5 | 3.8% | 5 | N | OK
B1 | EXTI15_10_IRQHandler | MMC5983MA INT (measurement done) | 1000 | 120 | 7500 | 0.8% | 6 | Y | OK
B1 | DMA2_Stream0_IRQHandler | SPI1 RX complete (stack) | 1000 | 250 | 15625 | 1.6% | 5 | Y | OK
B1 | EXTI4_IRQHandler | B2_INT (B2 frame ready) | 1000 | 120 | 7500 | 0.8% | 6 | Y | OK
B1 | USART1_IRQHandler | RS-485 IDLE (RX frames) + TC (release DE) | 2010 | 200 | 25125 | 2.5% | 5 | Y | OK | TC must drop DE within ~1 bit time; keep this the most urgent RTOS-aware IRQ.
B1 | DMA2_Stream2/7_IRQHandler | USART1 DMA half/complete | 2010 | 200 | 25125 | 2.5% | 5 | Y | OK
B1 | UART4_IRQHandler + DMA1_Stream2 | Stack UART IDLE / TX | 2000 | 200 | 25000 | 2.5% | 6 | Y | OK
B1 | SDIO_IRQHandler + DMA2_Stream6 | SD block transfer (≈3 IRQs per block) | 309.09375 | 300 | 5795.507812 | 0.6% | 7 | Y | OK
B1 | SysTick_Handler | FreeRTOS tick | 1000 | 200 | 12500 | 1.2% | 15 | Y | OK
B1 | PendSV (context switches) | ≈2 switches per loop | 2000 | 200 | 25000 | 2.5% | 15 | Y | OK
B2 | EXTI4_15_IRQHandler | BMI323 INT1 data-ready | 1000 | 60 | 3750 | 0.4% | 1 | N/A | OK
B2 | DMA1_Ch2_3_IRQHandler | SPI2 RX complete | 1000 | 80 | 5000 | 0.5% | 1 | N/A | OK
B2 | DMA1_Channel1_IRQHandler | SPI1 slave RX complete | 1000 | 80 | 5000 | 0.5% | 0 | N/A | OK | Highest priority: re-arm before the next CS.
B2 | USART3_4_LPUART1_IRQHandler | UART IDLE / TC | 2000 | 100 | 12500 | 1.2% | 2 | N/A | OK
B2 | SysTick_Handler | HAL tick | 1000 | 50 | 3125 | 0.3% | 3 | N/A | OK
B3 | USART1_IRQHandler | RS-485 IDLE + TC (DE) | 2010 | 100 | 12562.5 | 1.3% | 0 | N/A | OK
B3 | DMA1_Ch2_3 / Ch4_5_6_7 | USART1 + I2C1 DMA complete | 2060 | 80 | 10300 | 1.0% | 1 | N/A | OK
B3 | I2C1_IRQHandler | I2C phases (≈4 per txn) | 200 | 100 | 1250 | 0.1% | 2 | N/A | OK
B3 | TIM3_IRQHandler | PPS capture + 16-bit overflow counting | 16.25878906 | 60 | 60.97045898 | 0.006097045898% | 1 | N/A | OK
B3 | SysTick_Handler | HAL tick | 1000 | 50 | 3125 | 0.3% | 3 | N/A | OK
3 · CPU utilization per board (tasks from SW_Timing_Budgets §6 + interrupts above)
Board | SYSCLK (MHz) | ISR µs / s | Task µs / s | Total util | Allowed | Status | Max loop rate (Hz) | SYSCLK needed (MHz) | Notes
B1 | 16.0 | 234833.0078 | 976466.0156 | 121.1% | 70.0% | OVER | 577.8919874 | 27.7 | If OVER: raise SYSCLK to 168 MHz on SW_Timing_Budgets (APB1 ÷4, APB2 ÷2) and re-check the SPI2 prescaler.
B2 | 16.0 | 29375 | 168750 | 19.8% | 70.0% | OK | 3533.123028 | 4.5
B3 | 16.0 | 27298.47046 | 72937.5 | 10.0% | 70.0% | OK | 6983.520954 | 2.3

Sheet: Memory_Logging
Memory and logging budget · log volume, SD buffer, RAM, Flash
Log record layout drives the SD write rate (feeds transaction T13) and the buffer needed to ride out card stalls.
Legend: blue text = input you edit · yellow fill = key lever · black = formula · green = pulled from another sheet · status cells turn red/amber when a limit is broken.
1 · Log record contents
Field | Bytes | Rate (Hz) | Bytes / s | Notes
Sync + length | 3 | 1000 | 3000 | Per high-rate record
Timestamp (µs, u32) | 4 | 1000 | 4000 | TIM2 on B1
Sequence (u16) | 2 | 1000 | 2000
LSM6DSL gyro + accel (6 × i16) | 12 | 1000 | 12000
BMI323 gyro + accel (6 × i16) | 12 | 1000 | 12000 | From B2 via stack frame
MMC5983MA X/Y/Z (3 × 18-bit, packed) | 7 | 1000 | 7000 | Raw register image Xout0…XYZout2
Fusion output quaternion (4 × i16) | 8 | 1000 | 8000
Status / flags | 2 | 1000 | 2000
CRC16 | 2 | 1000 | 2000
GPS summary record | 48 | 10 | 480 | Low-rate record
B3 status record | 24 | 10 | 240 | Low-rate record (10 Hz assumed)
Event / text log | 32 | 1 | 32
Total | 156 |  | 52752
Log bytes per loop cycle |  |  | 52.8 | B | Feeds T13 occurrences on Interface_Data_Rates.
Log rate |  |  | 189.9 | MB/h
Mission duration |  |  | 120 | min | Assumption: edit.
Data per mission |  |  | 379.8 | MB
SD card size |  |  | 8 | GB | Assumption: edit.
Hours until card is full |  |  | 42.1258383 | h
Card minimum sequential write speed |  |  | 10.0 | MB/s | Class 10 / U1 = 10 MB/s.
Sustained write needed vs card min speed |  |  | 0.53%
2 · SD write buffer (must cover the worst card stall)
Worst-case SD write stall |  |  | 250 | ms | Cards stall 100–500 ms during wear levelling / erase. Measure your card.
f_write chunk size |  |  | 4096 | B | Multiple of 512; 4–16 KB lets the card use multi-block writes.
Data accumulated during a stall |  |  | 13188 | B
Required log buffer (ping-pong) |  |  | 17408 | B | Double buffer, rounded to 512 B. Put it in main SRAM (CCM is not DMA-reachable).
Write-to-card latency of a sample |  |  | 77.6 | ms | Time to fill one chunk before it is written.
3 · RAM budget
Board | Item | Bytes | Notes
B1 | FreeRTOS heap (configTOTAL_HEAP_SIZE) | 32768 | Holds task stacks/TCBs when created dynamically.
B1 | Log buffer (from §2) | 17408
B1 | DMA buffers (2 × bytes per stream) | 2446 | From the DMA table.
B1 | RS-485 + UART circular RX buffers | 512
B1 | FatFs (FATFS + FIL + sector buffer) | 5200 | _FS_TINY = 0
B1 | Fusion / filter state | 2048 | Estimate
B1 | HAL handles, globals, .data/.bss | 6144 | Estimate
B2 | DMA buffers | 256
B2 | Frame buffers | 256
B2 | Stack (MSP) | 2048
B2 | Globals, HAL | 3072 | Estimate
B3 | DMA buffers | 304
B3 | UBX parse buffer | 512
B3 | Stack (MSP) | 2048
B3 | Globals, HAL | 3072 | Estimate
Board | RAM used (B) | DMA-capable RAM (B) | Utilization | Status | Flash est. (KB) | Flash size (KB) | Flash util | Notes
B1 | 66526 | 131072 | 50.8% | OK | 96 | 1024 | 9.4% | F405: 128 KB SRAM1+2 (DMA-capable) + 64 KB CCM (CPU only — put stacks/filter state there). Flash estimate: HAL + FreeRTOS + FatFs + app.
B2 | 5632 | 36864 | 15.3% | OK | 24 | 128 | 18.8% | G071CB: 36 KB SRAM, 128 KB Flash.
B3 | 5936 | 36864 | 16.1% | OK | 28 | 128 | 21.9%

Sheet: Clock_Sync_Accuracy
Clock accuracy, time sync and latency budget
Crystal error + baud quantization against UART receiver tolerance; drift between boards; GPS PPS discipline; sensor-to-log latency.
Legend: blue text = input you edit · yellow fill = key lever · black = formula · green = pulled from another sheet · status cells turn red/amber when a limit is broken.
1 · Crystal (YXC X322516MLB4SI, 16 MHz, CL 9 pF) — confirm grades on the datasheet
Frequency tolerance @25 °C |  |  | 10.0 | ppm | Assumption; check part grade.
Temperature stability |  |  | 10.0 | ppm | Assumption over operating range.
Aging (1 year) |  |  | 3.0 | ppm | Assumption.
Load-cap mismatch pull |  |  | 5.0 | ppm | 10 pF fitted vs 9 pF CL spec with ~3 pF stray: small pull. Estimate.
Total worst-case error per board |  |  | 28.0 | ppm
2 · UART / RS-485 baud budget
Link | TX alloc | RX alloc | TX baud err | RX baud err | Crystal (both) | Edge distortion (ns) | Distortion (as % of 10-bit frame) | Total mismatch | Receiver tolerance | Margin | Status | Notes
B1 UART4 → B2 USART3 | B1-UART4 | B2-USART3 | 0.000% | 0.000% | 0.006% | 20 | 0.200% | 0.206% | 3.0% | 2.794% | OK | Stack header, 37 mm; Tolerance: RM0090/RM0444 give ≈3.3–3.75% for 16× oversampling; 3% used as derated.
B2 USART3 → B1 UART4 | B2-USART3 | B1-UART4 | 0.000% | 0.000% | 0.006% | 20 | 0.200% | 0.206% | 3.0% | 2.794% | OK | Tolerance: RM0090/RM0444 give ≈3.3–3.75% for 16× oversampling; 3% used as derated.
B1 USART1 → B3 USART1 (RS-485) | B1-USART1 | B3-USART1 | 0.000% | 0.000% | 0.006% | 30 | 0.300% | 0.306% | 3.0% | 2.694% | OK | Driver skew + cable dispersion over ~0.6 m; Tolerance: RM0090/RM0444 give ≈3.3–3.75% for 16× oversampling; 3% used as derated.
B3 USART1 → B1 USART1 (RS-485) | B3-USART1 | B1-USART1 | 0.000% | 0.000% | 0.006% | 30 | 0.300% | 0.306% | 3.0% | 2.694% | OK | Tolerance: RM0090/RM0444 give ≈3.3–3.75% for 16× oversampling; 3% used as derated.
3 · Inter-board time sync and GPS discipline
Resync interval (B1 broadcasts time every loop) |  |  | 0.0010 | s
Relative drift between two boards |  |  | 56.0 | ppm
Drift accumulated between resyncs |  |  | 0.056 | µs
ISR latency jitter (B2/B3, 16 MHz M0+) |  |  | 2.0 | µs | Estimate: 16–30 cycles entry + HAL overhead.
Sync error via SPI frame (latched at CS edge) |  |  | 3.06 | µs | Jitter + 1 timer tick + drift.
Sync error via RS-485 (latched at IDLE) |  |  | 12.06 | µs | IDLE fires one character after the last byte: correct for it in firmware to remove the 10-bit term.
MAX-M10S time pulse accuracy |  |  | 0.030 | µs | ≈30 ns RMS per u-blox M10 spec (verify in datasheet).
PPS capture resolution (B3 TIM3 tick) |  |  | 1.000 | µs | From SW_Timing_Budgets §5.
Holdover drift after GPS loss, 60 s |  |  | 1680 | µs | ppm × seconds = µs.
4 · Latency budget (ms): sample → B1 and sample → SD
Path | Stage | ms | Notes
LSM6DSL → SD | Sensor digital-filter group delay | 0.600 | Input: ODR/LPF dependent (≈1/ODR × filter order).
LSM6DSL → SD | Wait for loop tick (worst) | 1.000
LSM6DSL → SD | SPI2 read | 0.014
LSM6DSL → SD | Fusion + pack | 0.750
LSM6DSL → SD | Fill one f_write chunk | 77.646
LSM6DSL → SD | SD block writes for one chunk | 2.763 | Excludes stalls
BMI323 (B2) → B1 | Sensor filter delay | 0.600 | Input
BMI323 (B2) → B1 | B2 SPI2 read | 0.015
BMI323 (B2) → B1 | Wait for next stack exchange (worst) | 1.000
BMI323 (B2) → B1 | Stack SPI1 frame | 0.138
GPS → B1 | Receiver solution latency | 50.000 | Input: measurement epoch → NAV-PVT output (verify).
GPS → B1 | Poll interval wait (worst) | 25.000 | Removed by using GPS_INT
GPS → B1 | I2C NAV-PVT read | 2.330
GPS → B1 | Wait for RS-485 slot + frame | 1.560
Path | Total (ms) | Budget (ms) | Status
LSM6DSL → SD | 82.773 | 200.0 | OK
BMI323 (B2) → B1 | 1.753 | 5.0 | OK
GPS → B1 | 78.890 | 150.0 | OK

Sheet: Link_Margin_SI
Signal-integrity and link-margin budget
Critical length, SPI round-trip timing limit, I2C rise time, RS-485 DC level at the receiver. Frequencies link to the allocation table.
Legend: blue text = input you edit · yellow fill = key lever · black = formula · green = pulled from another sheet · status cells turn red/amber when a limit is broken.
1 · Edge rate vs trace / cable length
Link | Length (mm) | tpd (ps/mm) | Driver tr (ns) | Critical length (mm) | Regime | Signal freq (Hz) | Half period (ns) | Round trip (ns) | Settle 3× RT (ns) | Settle / half period | Status | Notes
B1 SPI2 → LSM6DSL | 15 | 6.2 | 1.5 | 40.3 | Lumped | 8000000 | 62.5 | 0.19 | 0.56 | 0.9% | OK | Inner-layer/microstrip FR4 ≈ 6.2 ps/mm. CubeMX default pin speed is very high (~1 ns edges).
B1 SPI1 → B2 (stack) | 37 | 6.2 | 3.0 | 80.6 | Lumped | 2000000 | 250.0 | 0.46 | 1.38 | 0.6% | OK | Medium slew set in fixed .ioc; 22 Ω source series R fitted.
B2 SPI2 → BMI323 | 15 | 6.2 | 1.5 | 40.3 | Lumped | 8000000 | 62.5 | 0.19 | 0.56 | 0.9% | OK
B1 UART4 ↔ B2 (stack) | 37 | 6.2 | 3.0 | 80.6 | Lumped | 1000000 | 500.0 | 0.46 | 1.38 | 0.3% | OK
RS-485 cable B1 ↔ B3 | 650 | 5.0 | 15.0 | 495.0 | TL: terminate | 1000000 | 500.0 | 6.57 | 19.70 | 3.9% | OK | Twisted pair vp ≈ 0.66 c. Above critical length but settles in a tiny fraction of the bit at 1 Mbaud, so unterminated is acceptable at 2 ft.
2 · SPI read-timing limit: f_max = 1 / (2 · (round trip + slave tv + master tsu))
Link | Length (mm) | tpd (ps/mm) | Slave tv(SO) (ns) | Master tsu(MI) (ns) | f_max (Hz) | Configured (Hz) | Margin | Status | Notes
B1 SPI2 → LSM6DSL | 15 | 6.2 | 50.0 | 5.0 | 9060268.909 | 8000000 | 11.7% | MARGINAL | LSM6DSL tv(SO) 50 ns max (datasheet SPI timing). F4 tsu(MI) ≈ 5 ns (estimate).
B1 SPI1 → B2 slave | 37 | 6.2 | 30.0 | 5.0 | 14100872 | 2000000 | 85.8% | OK | G071 slave tv(SO) assumed 30 ns; verify in G071 datasheet SPI table.
B2 SPI2 → BMI323 | 15 | 6.2 | 25.0 | 5.0 | 16563970.05 | 8000000 | 51.7% | OK | BMI323 output delay assumed 25 ns; verify.
3 · I2C rise time (tr = 0.8473 · Rp · Cb) and pull-up range
Bus | Rp (Ω) | Cb (pF) | VDD | tr (ns) | tr max (ns) | Rp min (Ω) | Rp max (Ω) | Status | Notes
B1 I2C1 (MMC5983MA) | 2700 | 50 | 3.30 | 114.3855 | 300 | 966.6666667 | 7081.317125 | OK | Cb estimate: device + traces + pins.
B3 I2C1 (MAX-M10S) | 4700 | 50 | 3.30 | 199.1155 | 300 | 966.6666667 | 7081.317125 | OK
4 · RS-485 DC level at the receiver: V_rx = Vod · R_load / (R_load + series R in path)
Scenario | Driver Vod (V) | Series R per board per line (Ω) | Series R in loop (Ω) | Terminators (120 Ω) fitted | R_load (Ω) | V_rx (V) | Rx threshold (V) | Margin × | Status | Notes
As built: 100 Ω series, no terminators | 2.00 | 100 | 400 | 0 | 12000.0 | 1.935 | 0.20 | 9.7 | OK | R2/R3 on B1, R11/R12 on B3: 4 resistors in the A–B loop. Series R acts as source termination.
100 Ω series + one 120 Ω terminator | 2.00 | 100 | 400 | 1 | 118.8 | 0.458 | 0.20 | 2.3 | MARGINAL | Divider loses most of the swing.
100 Ω series + two 120 Ω terminators | 2.00 | 100 | 400 | 2 | 59.7 | 0.260 | 0.20 | 1.3 | FAIL | Do not combine terminators with 100 Ω series.
10 Ω series + two 120 Ω terminators | 2.00 | 10 | 40 | 2 | 59.7 | 1.198 | 0.20 | 6.0 | OK | If you terminate, drop series R to 0–10 Ω and add ~680 Ω failsafe bias (SP3485 is not true failsafe).

Sheet: RF_GPS_Link
GNSS RF link budget and clock-harmonic check
C/N0 estimate via Friis cascade, and which on-board clock harmonics land inside GNSS bands. Clock frequencies link to SW_Timing_Budgets.
Legend: blue text = input you edit · yellow fill = key lever · black = formula · green = pulled from another sheet · status cells turn red/amber when a limit is broken.
1 · Link budget (GPS L1 C/A)
Signal power at antenna |  |  | -130.0 | dBm | GPS L1 C/A ≈ −128.5 to −130 dBm at Earth surface (IS-GPS-200 minimum).
Antenna element gain |  |  | 2.0 | dBic | Assumption: patch near zenith 3–5 dBic, low elevation negative.
Active antenna LNA gain |  |  | 28.0 | dB | Assumption: from your antenna datasheet.
Active antenna LNA noise figure |  |  | 1.5 | dB | Assumption.
Cable + connector loss |  |  | 0.5 | dB | Assumption: short RG-178 / U.FL-SMA.
PCB trace + edge SMA loss |  |  | 0.3 | dB | Estimate for ~43 Ω trace a few mm long + SMA.
Receiver noise figure (MAX-M10S) |  |  | 2.5 | dB | Assumption: not specified in the datasheet.
System noise figure (Friis) |  |  | 1.51 | dB | F = F_LNA + (L·F_rx − 1)/G_LNA
C/N0 estimate |  |  | 44.5 | dB-Hz | Good tracking ≥ 40 dB-Hz; acquisition degrades below ~35.
Tracking target |  |  | 40.0 | dB-Hz
Status |  |  | OK
Net external gain at RF_IN |  |  | 27.2 | dB | Compare with the maximum external gain in the MAX-M10 integration manual (input below).
Max external gain allowed |  |  | 30.0 | dB | Assumption — verify in the MAX-M10 integration manual.
Gain check |  |  | OK
2 · GNSS bands
Band | Centre (MHz) | Half-width (MHz) | Tracked? (Y/N) | Notes
GPS L1 / Galileo E1 | 1575.420 | 1.023 | Y | C/A main lobe ±1.023 MHz (E1 is wider, ±2.046)
BeiDou B1I | 1561.098 | 2.046 | Y | In the MAX-M10S default constellation set
GLONASS L1 | 1601.720 | 4.200 | N | 1598.06–1605.38 MHz. Not in the default set; enabling it puts 1600 MHz (100 × 16 MHz) in band.
3 · Clock harmonics vs GNSS bands (offset = n·f − band centre, n = nearest integer)
Clock | Board | f (MHz) | n (GPS L1) | GPS L1 offset (MHz) | B1I offset (MHz) | GLO offset (MHz) | In a band? | Risk | Notes
B1 SYSCLK | B1 | 16.000 | 98 | -7.420 | 6.902 | -1.720 | clear | OK
B1 SPI2 SCK (LSM6DSL) | B1 | 8.000 | 197 | 0.580 | -1.098 | -1.720 | IN BAND | MED | 8 MHz × 197 = 1576 MHz: inside GPS L1. Off-board from the GPS (cable), so low risk; keep it off B3.
B1 SPI1 SCK (stack) | B1 | 2.000 | 788 | 0.580 | 0.902 | 0.280 | IN BAND | LOW
B1 SDIO_CK | B1 | 24.000 | 66 | 8.580 | -1.098 | 6.280 | IN BAND | MED
B1 AP63203 switching | B1 | 1.100 | 1432 | -0.220 | -0.198 | -0.120 | IN BAND | LOW | Buck fsw 1.1 MHz (datasheet).
B2 SYSCLK | B2 | 16.000 | 98 | -7.420 | 6.902 | -1.720 | clear | OK
B2 SPI2 SCK (BMI323) | B2 | 8.000 | 197 | 0.580 | -1.098 | -1.720 | IN BAND | MED
B3 SYSCLK / HSE | B3 | 16.000 | 98 | -7.420 | 6.902 | -1.720 | clear | OK | 16 MHz × 98 = 1568 (7.4 MHz below L1, 6.9 above B1I) — clear but close; 64 MHz × 25 = 1600 lands in GLONASS.
B3 I2C1 SCL | B3 | 0.400 | 3939 | 0.180 | 0.102 | -0.120 | IN BAND | LOW | Very high harmonic order, slow edges: negligible.
B3 RS-485 1 Mbaud | B3 | 1.000 | 1575 | -0.420 | -0.098 | 0.280 | IN BAND | LOW
Only tracked bands count. Risk rule: HIGH = in band on Board 3 with harmonic order ≤ 200; MED = on B3 with order ≤ 1000, or any board with order ≤ 200; LOW = higher order (edge energy falls ~40 dB/decade above 1/(π·tr)).

Sheet: Magnetic_Interference
Magnetic interference budget (MMC5983MA, U3)
Allowed error derived from the heading accuracy you need; battery-current field from a go/return wire-pair model; arming magnet on-axis cylinder field.
Legend: blue text = input you edit · yellow fill = key lever · black = formula · green = pulled from another sheet · status cells turn red/amber when a limit is broken.
1 · Allowed error
Earth field, horizontal component |  |  | 19.0 | µT | Central Illinois ≈ 19–20 µT horizontal, ≈ 53 µT total (NOAA WMM). Edit for site.
Heading accuracy target |  |  | 1.0 | °
Allowed static error from on-board sources |  |  | 0.332 | µT | Unknown-but-constant fields can be calibrated out (hard-iron); varying currents cannot.
MMC5983MA full scale |  |  | 800 | µT | ±8 G.
2 · Current-carrying conductors near U3 (pair model: B = 2e-7·I·(1/d − 1/(d+s)))
Source | Current (mA) | Distance d (mm) | Pair spacing s (mm) | Field (µT) | Allowed (µT) | Status | Distance for allowed error (mm) | Notes
Battery leads at J4 — typical draw | 29.54 | 6.6 | 1.2 | 0.138 | 0.332 | OK | 4.6 | Current from Power_Budget at minimum battery voltage. 6.6 mm = U3 to J4 today.
Battery leads at J4 — max draw | 108.46 | 6.6 | 1.2 | 0.506 | 0.332 | OVER | 8.9
Battery leads at J4 — 1 A (your earlier worst-case guess) | 1000.00 | 6.6 | 1.2 | 4.662 | 0.332 | OVER | 26.9
3V3 feed trace near U3 — typical | 45.61 | 5.0 | 0.5 | 0.166 | 0.332 | OK | 3.7 | Assumption: trace with return on plane ≈ 0.5 mm below.
The "distance" column uses the far-field approximation d ≫ s. Twisting or tightly pairing battery leads shrinks s and the field with it.
3 · Arming magnet (N52 cylinder, on-axis field B = Br/2 · [(L+z)/√(R²+(L+z)²) − z/√(R²+z²)])
Remanence Br (N52) |  |  | 1.43 | T
Magnet radius |  |  | 3.0 | mm | 6 mm diameter.
Magnet length |  |  | 20.0 | mm
Distance (in) | z (mm) | Field (G) | Field (µT) | vs ±8 G FS | Notes
1.0 | 25.4 | 33.796 | 3379.635607 | OVER (saturates)
2.0 | 50.8 | 6.025 | 602.5177911 | OK
3.0 | 76.2 | 2.061 | 206.0651893 | OK | Your stated closest approach
4.0 | 101.6 | 0.940 | 93.99529535 | OK
6.0 | 152.4 | 0.303 | 30.26183828 | OK
Within range ≠ usable for heading: while the magnet is near, gate magnetometer data on |B| ≈ local Earth field and do a SET/RESET after it leaves.

Sheet: Thermal
Thermal budget · Tj = Ta + P · θJA
Power from Power_Budget (max case). θJA values are package typicals on a JEDEC board; your small 2-layer/4-layer board may be worse.
Legend: blue text = input you edit · yellow fill = key lever · black = formula · green = pulled from another sheet · status cells turn red/amber when a limit is broken.
Maximum ambient (payload bay) |  |  | 60 | °C | Assumption: edit.
Required margin to Tj max |  |  | 20 | °C
Ref | Part / package | P max (mW) | θJA (°C/W) | Tj (°C) | Tj max (°C) | Margin (°C) | Status | Basis
U1 | STM32F405 LQFP64 | 9.2 | 46 | 60.4 | 105 | 44.6 | OK | θJA from DS8626 package data (verify); Tj max 105 °C for 6-suffix temp range.
U7 | STM32G071 LQFP48 | 9.7 | 55 | 60.5 | 105 | 44.5 | OK | θJA assumption; check G071 datasheet.
U8 | STM32G071 LQFP48 | 9.7 | 55 | 60.5 | 105 | 44.5 | OK
U4 | AP63203 TSOT-23-6 (loss) | 84.6 | 90 | 67.6 | 125 | 57.4 | OK | Loss = Pout·(1/η − 1) at max load. θJA assumption.
Q1 | AO3401A SOT-23 (I²R) | 0.7 | 125 | 60.1 | 150 | 89.9 | OK | RθJA 125 °C/W steady state (AO3401A datasheet, verify).
U5 | SP3485 SOIC-8 | 57.6 | 125 | 67.2 | 125 | 57.8 | OK | θJA assumption for SOIC-8.
U13 | MAX-M10S module | 50.5 | 0 | 60.0 | 85 | 25.0 | OK | Module rated by ambient (−40…+85 °C): θJA set to 0, so this checks Ta.

Sheet: Pin_Map
Pin map and EXTI-line check (from the three .ioc files + netlist)
EXTI lines are shared by pin number across ports (PA6, PB6, PC6 → line 6). Set "EXTI?" to Y for every pin you want as an interrupt; clashes turn red.
Legend: blue text = input you edit · yellow fill = key lever · black = formula · green = pulled from another sheet · status cells turn red/amber when a limit is broken.
Board | Pin | Signal | Label / net | Peripheral | Dir | Pull / type | EXTI? | EXTI line | IRQ handler | EXTI check | Connects to | Notes
B1 | PA0 | UART4_TX | pcMCU_TX | UART4 | out | PP | N |  |  |  | J10.5 → B2 PB8 | Label says "pcMCU" but it is the B2 link.
B1 | PA1 | UART4_RX | pcMCU_RX | UART4 | in |  | N |  |  |  | J10.6 → B2 PB9
B1 | PA3 | GPIO_Output | GPIO_E | GPIO | out |  | N |  |  |  | B2 PB0 (E)
B1 | PA5 | SPI1_SCK | B2_CLK | SPI1 | out | medium | N |  |  |  | B2 PB3
B1 | PA6 | SPI1_MISO | B2_MISO | SPI1 | in |  | N |  |  |  | B2 PB4
B1 | PA7 | SPI1_MOSI | B2_MOSI | SPI1 | out | medium | N |  |  |  | B2 PB5
B1 | PB1 | GPIO_Output | B2_CS | GPIO | out | medium | N |  |  |  | B2 PB6
B1 | PB5 | GPIO_Output | RS485_MODE_SW | GPIO | out |  | N |  |  |  | U5 DE/RE | Default low (receive).
B1 | PB6 | USART1_TX | RS485_TX | USART1 | out |  | N |  |  |  | U5 DI
B1 | PB7 | USART1_RX | RS485_RX | USART1 | in |  | N |  |  |  | U5 RO
B1 | PB8 | I2C1_SCL | MAG_SCL | I2C1 | od | 2.7k ext | N |  |  |  | U3
B1 | PB9 | I2C1_SDA | MAG_SDA | I2C1 | od | 2.7k ext | N |  |  |  | U3
B1 | PB11 | GPIO_Output | GPIO_A | GPIO | out |  | N |  |  |  | B2 PB11 (A)
B1 | PB12 | GPIO_Output | LSM_CS | GPIO | out |  | N |  |  |  | U2 CS
B1 | PB13 | SPI2_SCK | LSM_CLK | SPI2 | out |  | N |  |  |  | U2
B1 | PB14 | SPI2_MISO | LSM_MISO | SPI2 | in |  | N |  |  |  | U2
B1 | PB15 | SPI2_MOSI | LSM_MOSI | SPI2 | out |  | N |  |  |  | U2
B1 | PC0 | GPIO_Input | GPIO_D | GPIO | in | pull-down | N |  |  |  | B2 PB1 (D) | B2 side is also an input: nothing drives this line. Make one side an output.
B1 | PC1 | GPIO_Input | GPIO_C | GPIO | in | pull-down | N |  |  |  | B2 PB2 (C) | Same: both ends inputs.
B1 | PC2 | GPIO_Input | GPIO_B | GPIO | in | pull-down | N |  |  |  | B2 PB10 (B) | Same: both ends inputs.
B1 | PC3 | GPIO_Output | USR_LED | GPIO | out |  | N |  |  |  | D1
B1 | PC4 | GPIO_EXTI | B2_INT | EXTI | in |  | Y | 4 | EXTI4 | OK | B2 PB12 | B2 frame-ready interrupt.
B1 | PC6 | GPIO_EXTI | LSM_INT1 | EXTI | in |  | Y | 6 | EXTI9_5 | OK | U2 INT1 | Data-ready.
B1 | PC7 | GPIO_Input | LSM_INT2 | GPIO | in |  | N |  |  |  | U2 INT2
B1 | PC8 | SDIO_D0 |  | SDIO | io | RN1 10k | N |  |  |  | J1
B1 | PC9 | SDIO_D1 |  | SDIO | io | RN1 10k | N |  |  |  | J1
B1 | PC10 | SDIO_D2 |  | SDIO | io | RN1 10k | N |  |  |  | J1
B1 | PC11 | SDIO_D3 |  | SDIO | io | RN1 10k | N |  |  |  | J1
B1 | PC12 | SDIO_CK |  | SDIO | out |  | N |  |  |  | J1
B1 | PD2 | SDIO_CMD |  | SDIO | io |  | N |  |  |  | J1
B1 | PC13 | GPIO_EXTI | MAG_INT | EXTI | in |  | Y | 13 | EXTI15_10 | OK | U3 INT | PC13 is a low-drive RTC-domain pin: input only, fine.
B1 | PA13 | SWDIO |  | SYS | io |  | N |  |  |  | debug
B1 | PA14 | SWCLK |  | SYS | in |  | N |  |  |  | debug
B1 | PA15 | (removed) | SD_Detect | — |  |  | N |  |  |  |  | Removed in fixed .ioc: J1 footprint has no detect pad.
B2 | PA8 | GPIO_Output | BMI_CS | GPIO | out |  | N |  |  |  | U12 CSB
B2 | PA9 | GPIO_Input | BMI_INT2 | GPIO | in |  | N |  |  |  | U12 INT2 | Free EXTI line 9: good home for BMI data-ready if PC6 is needed elsewhere.
B2 | PB0 | GPIO_Input | E | GPIO | in |  | N |  |  |  | B1 PA3
B2 | PB1 | GPIO_Input | D | GPIO | in |  | N |  |  |  | B1 PC0 | Both ends inputs.
B2 | PB2 | GPIO_Input | C | GPIO | in |  | N |  |  |  | B1 PC1 | Both ends inputs.
B2 | PB10 | GPIO_Input | B | GPIO | in |  | N |  |  |  | B1 PC2 | Both ends inputs.
B2 | PB11 | GPIO_Input | A | GPIO | in |  | N |  |  |  | B1 PB11
B2 | PB12 | GPIO_Output | B2_INT | GPIO | out |  | N |  |  |  | B1 PC4
B2 | PB13 | SPI2_SCK | BMI_CLK | SPI2 | out |  | N |  |  |  | U12
B2 | PB14 | SPI2_MISO | BMI_MISO | SPI2 | in |  | N |  |  |  | U12
B2 | PB15 | SPI2_MOSI | BMI_MOSI | SPI2 | out |  | N |  |  |  | U12
B2 | PB3 | SPI1_SCK | B_CLK | SPI1 | in |  | N |  |  |  | B1 PA5 | Slave
B2 | PB4 | SPI1_MISO | B_MISO | SPI1 | out | medium | N |  |  |  | B1 PA6
B2 | PB5 | SPI1_MOSI | B_MOSI | SPI1 | in |  | N |  |  |  | B1 PA7
B2 | PB6 | GPIO_EXTI | B_CS | EXTI | in |  | Y | 6 | EXTI4_15 | CONFLICT | B1 PB1 | If CS is used as an EXTI (frame sync), line 6 clashes with PC6 BMI_INT1. Fix: move BMI data-ready to INT2 (PA9) or don't interrupt on CS.
B2 | PB8 | USART3_TX→RX (swap) | B2_MCU_RX | USART3 | in |  | N |  |  |  | B1 PA0
B2 | PB9 | USART3_RX→TX (swap) | B2_MCU_TX | USART3 | out | medium | N |  |  |  | B1 PA1
B2 | PC6 | GPIO_EXTI | BMI_INT1 | EXTI | in |  | Y | 6 | EXTI4_15 | CONFLICT | U12 INT1
B2 | PC13 | GPIO_Output | B2_USRLED | GPIO | out |  | N |  |  |  | D2
B3 | PB3 | GPIO_Output | GPS_LNA_EN | GPIO | out |  | N |  |  |  | U13 LNA_EN
B3 | PB4 | TIM3_CH1 (to set) | GPS_TIMEPULSE | TIM3 | in |  | N |  |  |  | U13 TIMEPULSE | .ioc has GPIO_Input: change to TIM3_CH1 (AF1) for PPS capture.
B3 | PB5 | GPIO_Output | RS_485_MODE_SW | GPIO | out |  | N |  |  |  | U9 DE/RE
B3 | PB6 | USART1_TX→RX (swap) | RS485_MCU_TX | USART1 | in |  | N |  |  |  | U9
B3 | PB7 | USART1_RX→TX (swap) | RS485_MCU_RX | USART1 | out |  | N |  |  |  | U9
B3 | PB8 | I2C1_SCL | GPS_SCL | I2C1 | od | 4.7k ext | N |  |  |  | U13
B3 | PB9 | I2C1_SDA | GPS_SDA | I2C1 | od | 4.7k ext | N |  |  |  | U13
B3 | PC13 | GPIO_EXTI | GPS_INT | EXTI | in |  | Y | 13 | EXTI4_15 | OK | U13 TXD/ready | Use as TX-ready to replace I2C polling (T11).
B3 | PC15 | GPIO_Output OD | GPS_RST | GPIO | out | open-drain, idle high | N |  |  |  | U13 RESET_N
B3 | PD0 | GPIO_Output | USR_LED | GPIO | out |  | N |  |  |  | D3

Sheet: Cost_BOM
Cost budget · JLCPCB assembly (from BOM-main.csv)
Enter LCSC unit prices and confirm Basic/Extended on LCSC; fees are inputs because JLC pricing changes.
Legend: blue text = input you edit · yellow fill = key lever · black = formula · green = pulled from another sheet · status cells turn red/amber when a limit is broken.
Panels assembled |  |  | 5 | pcs | Each panel = one B1 + B2 + B3 set.
Extended-part fee |  |  | $3.00 | $ / unique part | JLC loading fee per unique Extended part (verify current pricing).
Assembly setup + stencil |  |  | $8.00 | $ | Assumption: check the JLC quote.
Value | Designators | LCSC | Qty / set | Basic / Extended | Unit price ($) | Ext. price ($) | Notes
10 | R13 | C22859 | 1 | Basic? |  | $0.00
100 | R2,R3,R11,R12 | C22775 | 4 | Basic |  | $0.00
100k | R1 | C25803 | 1 | Basic |  | $0.00
10k | R4,R5,R9,R10,R18,R19,R20 | C25804 | 7 | Basic |  | $0.00
10k ×4 array | RN1 | C29718 | 1 | Basic? |  | $0.00
10n | C43 | C57112 | 1 | Basic? |  | $0.00
10p C0G | C47–C52 | C1634 | 6 | Basic |  | $0.00
100n | 27 caps | C14663 | 27 | Basic |  | $0.00
10u 0603 | C24,C37,C41 | C19702 | 3 | Basic |  | $0.00
10u 25V 0805 | C16 | C15850 | 1 | Basic |  | $0.00
16 MHz xtal | U6,U10,U11 | C13738 | 3 | ? |  | $0.00
1k | R8,R14,R15 | C21190 | 3 | Basic |  | $0.00
1u | C7,C8,C13,C25 | C15849 | 4 | Basic |  | $0.00
2.2u | C44,C45 | C23630 | 2 | Basic? |  | $0.00
2.7k | R6,R7 | C13167 | 2 | Basic? |  | $0.00
22 | R21,R22,R23 | C23345 | 3 | Basic |  | $0.00
22u | C18,C21 | C59461 | 2 | Basic |  | $0.00
27n | L2 | C12669 | 1 | ? |  | $0.00
4.7k | R16,R17 | C23162 | 2 | Basic |  | $0.00
4.7u inductor | L1 | C128688 | 1 | ? |  | $0.00 | Footprint mismatch flagged in review.
4.7u cap | C1,C11,C15 | C19666 | 3 | Basic |  | $0.00
AO3401A | Q1 | C15127 | 1 | Basic |  | $0.00
AP63203WU | U4 | C780769 | 1 | Extended |  | $0.00
BMI323 | U12 | C5368700 | 1 | Extended |  | $0.00
LED red | D1,D2,D3 | C84256 | 3 | Basic |  | $0.00
LSM6DSL | U2 | C126672 | 1 | Extended |  | $0.00
MMC5983MA | U3 | C404329 | 1 | Extended |  | $0.00
microSD | J1 | C164170 | 1 | Extended |  | $0.00
SP3485EN | U5,U9 | C8963 | 2 | Basic |  | $0.00
STM32F405RGT6 | U1 | C15742 | 1 | Extended |  | $0.00
STM32G071CBT6 | U7,U8 | C432212 | 2 | Extended |  | $0.00
Unique Extended parts |  |  | 7 |  | "?" rows are unverified; check each on LCSC.
Extended fees |  |  | $21.00 | $
Parts |  |  | $0.00 | $ | Blank unit prices count as $0.
Assembly total (excl. PCB, shipping) |  |  | $29.00 | $
Unpriced lines |  |  | 31

Sheet: Summary_Index
Summary and index
Live headline numbers pulled from every budget, then the sheet map by category.
Legend: blue text = input you edit · yellow fill = key lever · black = formula · green = pulled from another sheet · status cells turn red/amber when a limit is broken.
Headline checks
Check | Value | Status | Where
Loop rate target (Hz) | 1000.0 | OK | SW_Timing_Budgets §1
DMA stream conflicts | 1.0 | CONFLICT | SW_Timing_Budgets §4
Peripheral setting violations | 0.0 | OK | SW_Timing_Budgets §3
Worst bus utilization | 48.6% | OK | Interface_Data_Rates §3
B1 CPU utilization | 121.1% | OVER | CPU_Load §3
B2 CPU utilization | 19.8% | OK | CPU_Load §3
B3 CPU utilization | 10.0% | OK | CPU_Load §3
B1 worst-cycle CPU critical path (µs) | 1325.0 | OVER | SW_Timing_Budgets §6
Busiest loop-synchronous bus, worst cycle (µs) | 1040.0 | OVER | Interface_Data_Rates §3
3V3 typical load (mA) | 45.613 | — | Power_Budget §2
Battery current, typical @ nominal (mA) | 23.953 | — | Power_Budget §3
Runtime on stated pack (h) | 66.798 | — | Power_Budget §3
EXTI line conflicts | 2.0 | CONFLICT | Pin_Map
GNSS C/N0 estimate (dB-Hz) | 44.494 | OK | RF_GPS_Link
Required SD log buffer (B) | 17408.0 | — | Memory_Logging §2
Sheet map
Category | Sheet | What it answers
Software infrastructure | SW_Timing_Budgets | Clock tree, peripheral/DMA/timer allocation with conflict checks, per-cycle task timeline.
Software infrastructure | Interface_Data_Rates | Every message on every bus: time, rate, utilization, max loop rate per bus.
Software infrastructure | CPU_Load | ISR + task load per MCU, NVIC/FreeRTOS priority rules, SYSCLK needed.
Software infrastructure | Memory_Logging | Log volume, SD stall buffer, RAM/Flash per MCU.
Software infrastructure | Pin_Map | Pin → signal → peripheral, EXTI-line clashes, cross-board direction issues.
Timing & synchronization | Clock_Sync_Accuracy | Crystal ppm vs UART tolerance, inter-board sync error, GPS PPS, end-to-end latency.
Electrical | Power_Budget | Per-component min/typ/max/peak current and power, buck and battery current, runtime, ratings.
Electrical | Thermal | Junction temperature per hot part at max ambient.
Signal / RF / EMC | Link_Margin_SI | Critical length, SPI timing limit, I2C rise time, RS-485 receiver level per termination option.
Signal / RF / EMC | RF_GPS_Link | GNSS C/N0 cascade and clock harmonics landing in GNSS bands.
Signal / RF / EMC | Magnetic_Interference | Battery-current field at U3, arming-magnet field vs full scale, distance needed.
Program | Cost_BOM | JLC assembly cost from the BOM, Extended-part fees.
