AlephInfi/PRISTA/main/main.kicad_pcb

## KiCad design main/main.kicad_pcb (2026-10-29)

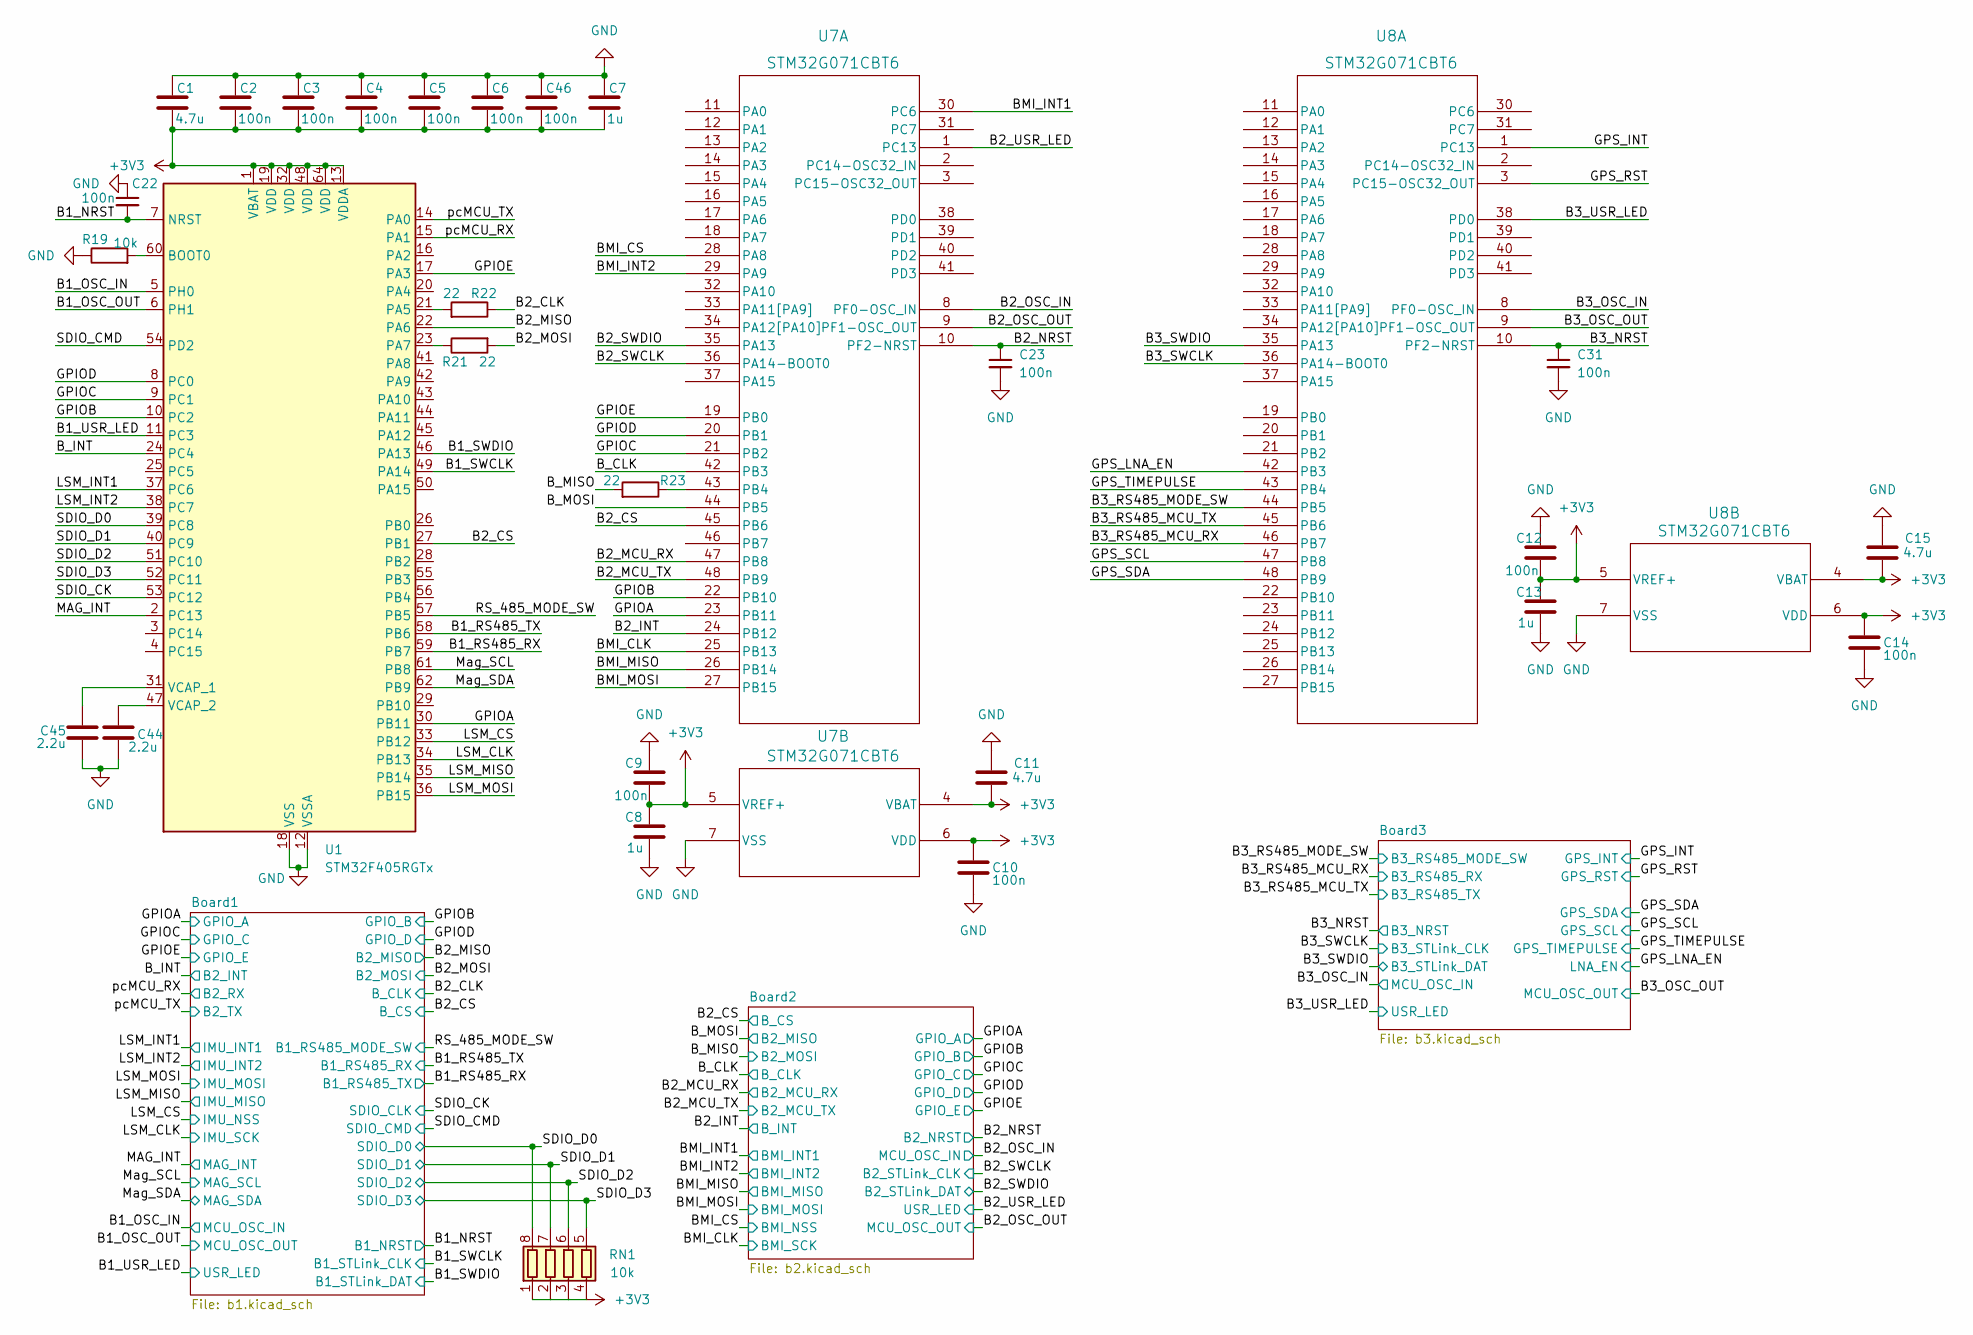
[picture p1: schematic main.kicad_sch]

Parts:
C1, C11, C15: 4.7u; C_0603_1608Metric
C2, C3, C4, C5, C6, C9, C10, C12, C14, C22, C23, C31, C46: 100n; C_0603_1608Metric
C7, C8, C13: 1u; C_0603_1608Metric
C44, C45: 2.2u; C_0603_1608Metric
R19: 10k; R_0603_1608Metric
R21, R22, R23: 22; R_0603_1608Metric; LCSC C23345
RN1: 10k; R_Array_Convex_4x0603; MPN UNI-ROYAL 4D03WGJ0103T5E; LCSC C29718
U1: STM32F405RGTx; LQFP-64_10x10mm_P0.5mm
U7, U8: STM32G071CBT6; LQFP-48_7x7mm_P0.5mm

Connections:
+3V3: C1.2, C2.2, C3.2, C4.2, C5.2, C6.2, C7.2, C8.1, C9.2, C10.1, C11.2, C12.2, C13.1, C14.1, C15.2, C46.2, RN1.1 (R1.1), RN1.2 (R2.1), RN1.3 (R3.1), RN1.4 (R4.1), U1.1 (VBAT), U1.13 (VDDA), U1.19 (VDD), U1.32 (VDD), U1.48 (VDD), U1.64 (VDD), U7.4 (VBAT), U7.5 (VREF+), U7.6 (VDD), U8.4 (VBAT), U8.5 (VREF+), U8.6 (VDD); also elsewhere on the board
/B1_NRST: C22.2, U1.7 (NRST); also elsewhere on the board
/B1_OSC_IN: U1.5 (PH0); also elsewhere on the board
/B1_OSC_OUT: U1.6 (PH1); also elsewhere on the board
/B1_RS485_RX: U1.59 (PB7); also elsewhere on the board
/B1_RS485_TX: U1.58 (PB6); also elsewhere on the board
/B1_SWCLK: U1.49 (PA14); also elsewhere on the board
/B1_SWDIO: U1.46 (PA13); also elsewhere on the board
/B1_USR_LED: U1.11 (PC3); also elsewhere on the board
/B2_CLK: R22.1; also elsewhere on the board
/B2_CS: U1.27 (PB1), U7.45 (PB6); also elsewhere on the board
/B2_INT: U7.24 (PB12); also elsewhere on the board
/B2_MCU_RX: U7.47 (PB8); also elsewhere on the board
/B2_MCU_TX: U7.48 (PB9); also elsewhere on the board
/B2_MISO: U1.22 (PA6); also elsewhere on the board
/B2_MOSI: R21.2; also elsewhere on the board
/B2_NRST: C23.1, U7.10 (PF2-NRST); also elsewhere on the board
/B2_OSC_IN: U7.8 (PF0-OSC_IN); also elsewhere on the board
/B2_OSC_OUT: U7.9 (PF1-OSC_OUT); also elsewhere on the board
/B2_SWCLK: U7.36 (PA14-BOOT0); also elsewhere on the board
/B2_SWDIO: U7.35 (PA13); also elsewhere on the board
/B2_USR_LED: U7.1 (PC13); also elsewhere on the board
/B3_NRST: C31.1, U8.10 (PF2-NRST); also elsewhere on the board
/B3_OSC_IN: U8.8 (PF0-OSC_IN); also elsewhere on the board
/B3_OSC_OUT: U8.9 (PF1-OSC_OUT); also elsewhere on the board
/B3_RS485_MCU_RX: U8.46 (PB7); also elsewhere on the board
/B3_RS485_MCU_TX: U8.45 (PB6); also elsewhere on the board
/B3_RS485_MODE_SW: U8.44 (PB5); also elsewhere on the board
/B3_SWCLK: U8.36 (PA14-BOOT0); also elsewhere on the board
/B3_SWDIO: U8.35 (PA13); also elsewhere on the board
/B3_USR_LED: U8.38 (PD0); also elsewhere on the board
/BMI_CLK: U7.25 (PB13); also elsewhere on the board
/BMI_CS: U7.28 (PA8); also elsewhere on the board
/BMI_INT1: U7.30 (PC6); also elsewhere on the board
/BMI_INT2: U7.29 (PA9); also elsewhere on the board
/BMI_MISO: U7.26 (PB14); also elsewhere on the board
/BMI_MOSI: U7.27 (PB15); also elsewhere on the board
/B_CLK: U7.42 (PB3); also elsewhere on the board
/B_INT: U1.24 (PC4); also elsewhere on the board
/B_MISO: R23.2; also elsewhere on the board
/B_MOSI: U7.44 (PB5); also elsewhere on the board
/GPIOA: U1.30 (PB11), U7.23 (PB11); also elsewhere on the board
/GPIOB: U1.10 (PC2), U7.22 (PB10); also elsewhere on the board
/GPIOC: U1.9 (PC1), U7.21 (PB2); also elsewhere on the board
/GPIOD: U1.8 (PC0), U7.20 (PB1); also elsewhere on the board
/GPIOE: U1.17 (PA3), U7.19 (PB0); also elsewhere on the board
/GPS_INT: U8.1 (PC13); also elsewhere on the board
/GPS_LNA_EN: U8.42 (PB3); also elsewhere on the board
/GPS_RST: U8.3 (PC15-OSC32_OUT); also elsewhere on the board
/GPS_SCL: U8.47 (PB8); also elsewhere on the board
/GPS_SDA: U8.48 (PB9); also elsewhere on the board
/GPS_TIMEPULSE: U8.43 (PB4); also elsewhere on the board
/LSM_CLK: U1.34 (PB13); also elsewhere on the board
/LSM_CS: U1.33 (PB12); also elsewhere on the board
/LSM_INT1: U1.37 (PC6); also elsewhere on the board
/LSM_INT2: U1.38 (PC7); also elsewhere on the board
/LSM_MISO: U1.35 (PB14); also elsewhere on the board
/LSM_MOSI: U1.36 (PB15); also elsewhere on the board
/MAG_INT: U1.2 (PC13); also elsewhere on the board
/Mag_SCL: U1.61 (PB8); also elsewhere on the board
/Mag_SDA: U1.62 (PB9); also elsewhere on the board
/RS_485_MODE_SW: U1.57 (PB5); also elsewhere on the board
/SDIO_CK: U1.53 (PC12); also elsewhere on the board
/SDIO_CMD: U1.54 (PD2); also elsewhere on the board
/SDIO_D0: RN1.8 (R1.2), U1.39 (PC8); also elsewhere on the board
/SDIO_D1: RN1.7 (R2.2), U1.40 (PC9); also elsewhere on the board
/SDIO_D2: RN1.6 (R3.2), U1.51 (PC10); also elsewhere on the board
/SDIO_D3: RN1.5 (R4.2), U1.52 (PC11); also elsewhere on the board
/pcMCU_RX: U1.15 (PA1); also elsewhere on the board
/pcMCU_TX: U1.14 (PA0); also elsewhere on the board
GND: C1.1, C2.1, C3.1, C4.1, C5.1, C6.1, C7.1, C8.2, C9.1, C10.2, C11.1, C12.1, C13.2, C14.2, C15.1, C22.1, C23.2, C31.2, C44.2, C45.2, C46.1, R19.1, U1.12 (VSSA), U1.18 (VSS), U1.63 (VSS), U7.7 (VSS), U8.7 (VSS); also elsewhere on the board
unnamed: R19.2, U1.60 (BOOT0)
unnamed: R22.2, U1.21 (PA5)
unnamed: R21.1, U1.23 (PA7)
unnamed: C45.1, U1.31 (VCAP_1)
unnamed: C44.1, U1.47 (VCAP_2)
unnamed: R23.1, U7.43 (PB4)

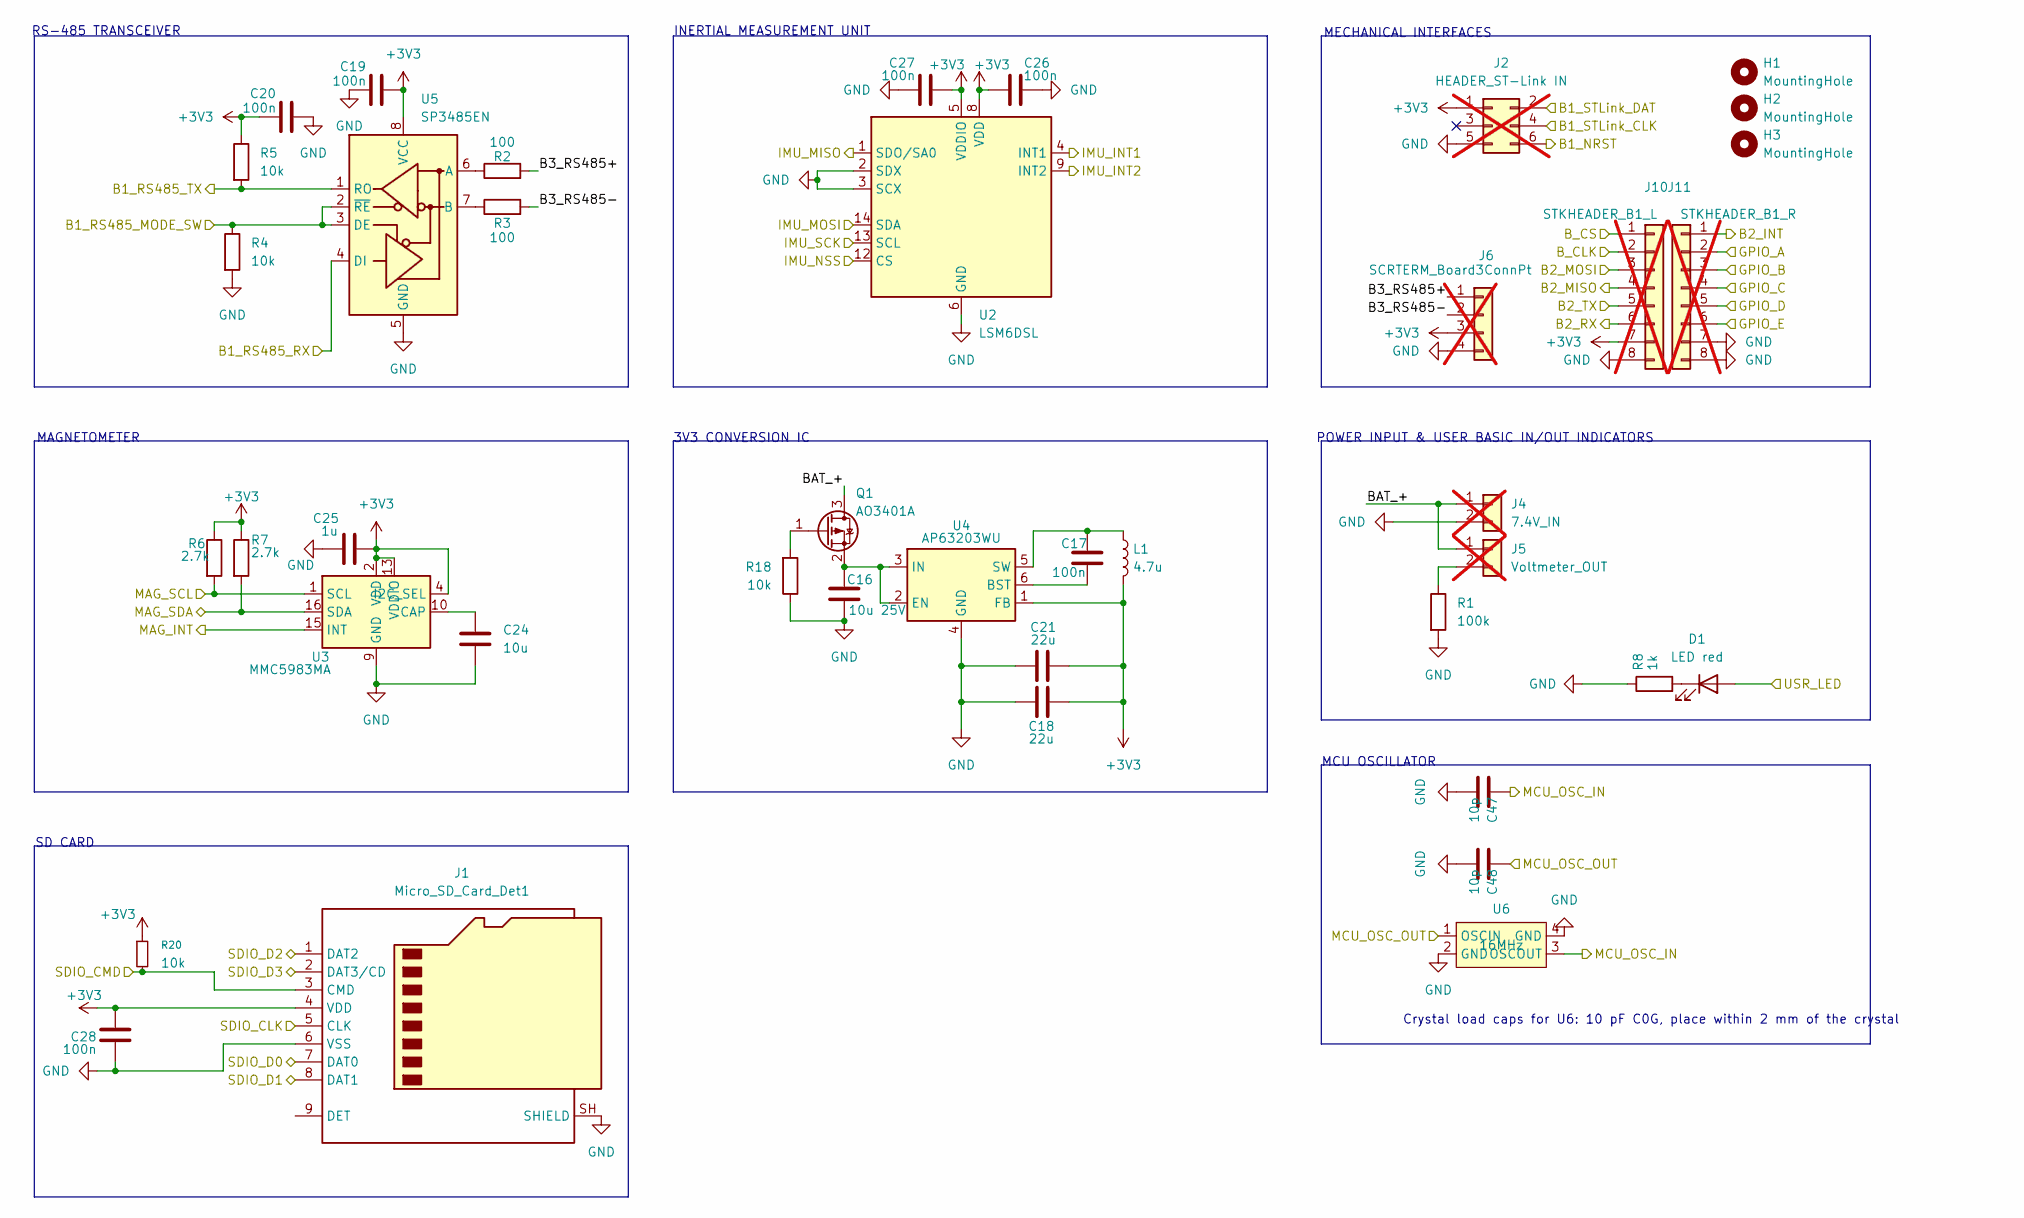
[picture p2: schematic b1.kicad_sch]

Parts:
C16: 10u 25V; C_0805_2012Metric; LCSC C15850
C17, C19, C20, C26, C27, C28: 100n; C_0603_1608Metric
C18, C21: 22u; C_0603_1608Metric; LCSC C59461
C24: 10u; C_0603_1608Metric
C25: 1u; C_0603_1608Metric
C47, C48: 10p; C_0603_1608Metric; LCSC C1634
D1: LED red; LED_0805_2012Metric; LCSC C84256
H1, H2, H3: MountingHole; MountingHole_3.2mm_M3
J1: Micro_SD_Card_Det1; microSD_HC_Molex_47219-2001
J2: HEADER_ST-Link IN; PinHeader_2x03_P2.54mm_Horizontal; not fitted
J4: 7.4V_IN; TerminalBlock_Phoenix_MKDS-1-2-3.81_1x02_P3.81mm_Horizontal; not fitted
J5: Voltmeter_OUT; TerminalBlock_Phoenix_MKDS-1-2-3.81_1x02_P3.81mm_Horizontal; not fitted
J6: SCRTERM_Board3ConnPt; TerminalBlock_Phoenix_MKDS-1-4-3.81_1x04_P3.81mm_Horizontal; not fitted
J10: STKHEADER_B1_R; PinHeader_1x08_P2.54mm_Vertical; not fitted
J11: STKHEADER_B1_L; PinHeader_1x08_P2.54mm_Vertical; not fitted
L1: 4.7u; L_6.3x6.3_H3
Q1: AO3401A; SOT-23; LCSC C15127
R1: 100k; R_0603_1608Metric
R2, R3: 100; R_0603_1608Metric
R4, R5, R18, R20: 10k; R_0603_1608Metric
R6, R7: 2.7k; R_0603_1608Metric
R8: 1k; R_0603_1608Metric
U2: LSM6DSL; LGA-14_3x2.5mm_P0.5mm_LayoutBorder3x4y
U3: MMC5983MA; LGA-16_3x3mm_P0.5mm
U4: AP63203WU; TSOT-23-6
U5: SP3485EN; SOIC-8_3.9x4.9mm_P1.27mm; LCSC C8963
U6: 16MHz; Crystal_SMD_3225-4Pin_3.2x2.5mm; MPN YXC X322516MLB4SI; LCSC C13738

Connections:
+3V3: C18.1, C19.2, C20.1, C21.1, C25.2, C26.1, C27.2, C28.1, J1.4 (VDD), J2.1, J6.3, J10.7, L1.2, R5.1, R6.1, R7.1, R20.1, U2.5 (VDDIO), U2.8 (VDD), U3.2 (VDD), U3.4 (I2C_SEL), U3.13 (VDDIO), U4.1 (FB), U5.8 (VCC); also elsewhere on the board
/B1_NRST: J2.6; also elsewhere on the board
/B1_OSC_IN: C47.1, U6.3 (OSCOUT); also elsewhere on the board
/B1_OSC_OUT: C48.1, U6.1 (OSCIN); also elsewhere on the board
/B1_RS485_RX: R5.2, U5.1 (RO); also elsewhere on the board
/B1_RS485_TX: U5.4 (DI); also elsewhere on the board
/B1_SWCLK: J2.4; also elsewhere on the board
/B1_SWDIO: J2.2; also elsewhere on the board
/B1_USR_LED: D1.2 (A); also elsewhere on the board
/B2_CLK: J10.2; also elsewhere on the board
/B2_CS: J10.1; also elsewhere on the board
/B2_MISO: J10.4; also elsewhere on the board
/B2_MOSI: J10.3; also elsewhere on the board
/B_INT: J11.1; also elsewhere on the board
/Board1/B3_RS485+: J6.1, R2.2
/Board1/B3_RS485-: J6.2, R3.2
/Board1/BAT_+: J4.1, J5.1, Q1.3 (D)
/GPIOA: J11.2; also elsewhere on the board
/GPIOB: J11.3; also elsewhere on the board
/GPIOC: J11.4; also elsewhere on the board
/GPIOD: J11.5; also elsewhere on the board
/GPIOE: J11.6; also elsewhere on the board
/LSM_CLK: U2.13 (SCL); also elsewhere on the board
/LSM_CS: U2.12 (CS); also elsewhere on the board
/LSM_INT1: U2.4 (INT1); also elsewhere on the board
/LSM_INT2: U2.9 (INT2); also elsewhere on the board
/LSM_MISO: U2.1 (SDO/SA0); also elsewhere on the board
/LSM_MOSI: U2.14 (SDA); also elsewhere on the board
/MAG_INT: U3.15 (INT); also elsewhere on the board
/Mag_SCL: R6.2, U3.1 (SCL); also elsewhere on the board
/Mag_SDA: R7.2, U3.16 (SDA); also elsewhere on the board
/RS_485_MODE_SW: R4.1, U5.2 (~RE), U5.3 (DE); also elsewhere on the board
/SDIO_CK: J1.5 (CLK); also elsewhere on the board
/SDIO_CMD: J1.3 (CMD), R20.2; also elsewhere on the board
/SDIO_D0: J1.7 (DAT0); also elsewhere on the board
/SDIO_D1: J1.8 (DAT1); also elsewhere on the board
/SDIO_D2: J1.1 (DAT2); also elsewhere on the board
/SDIO_D3: J1.2 (DAT3/CD); also elsewhere on the board
/pcMCU_RX: J10.6; also elsewhere on the board
/pcMCU_TX: J10.5; also elsewhere on the board
GND: C16.2, C18.2, C19.1, C20.2, C21.2, C24.2, C25.1, C26.2, C27.1, C28.2, C47.2, C48.2, J1.6 (VSS), J1.SH (SHIELD), J2.5, J4.2, J6.4, J10.8, J11.7, J11.8, R1.2, R4.2, R8.1, R18.1, U2.2 (SDX), U2.3 (SCX), U2.6 (GND), U2.7 (GND), U3.9 (GND), U3.11 (GND), U4.4 (GND), U5.5 (GND), U6.2 (GND), U6.4 (GND); also elsewhere on the board
unnamed: D1.1 (K), R8.2
unnamed: J5.2, R1.1
unnamed: Q1.1 (G), R18.2
unnamed: C16.1, Q1.2 (S), U4.2 (EN), U4.3 (IN)
unnamed: C24.1, U3.10 (CAP)
unnamed: C17.2, U4.6 (BST)
unnamed: C17.1, L1.1, U4.5 (SW)
unnamed: R2.1, U5.6 (A)
unnamed: R3.1, U5.7 (B)

Notes on the sheet:
INERTIAL MEASUREMENT UNIT
MAGNETOMETER
Crystal load caps for U6: 10 pF C0G, place within 2 mm of the crystal
POWER INPUT & USER BASIC IN/OUT INDICATORS
MCU OSCILLATOR
RS-485 TRANSCEIVER
SD CARD
3V3 CONVERSION IC
MECHANICAL INTERFACES

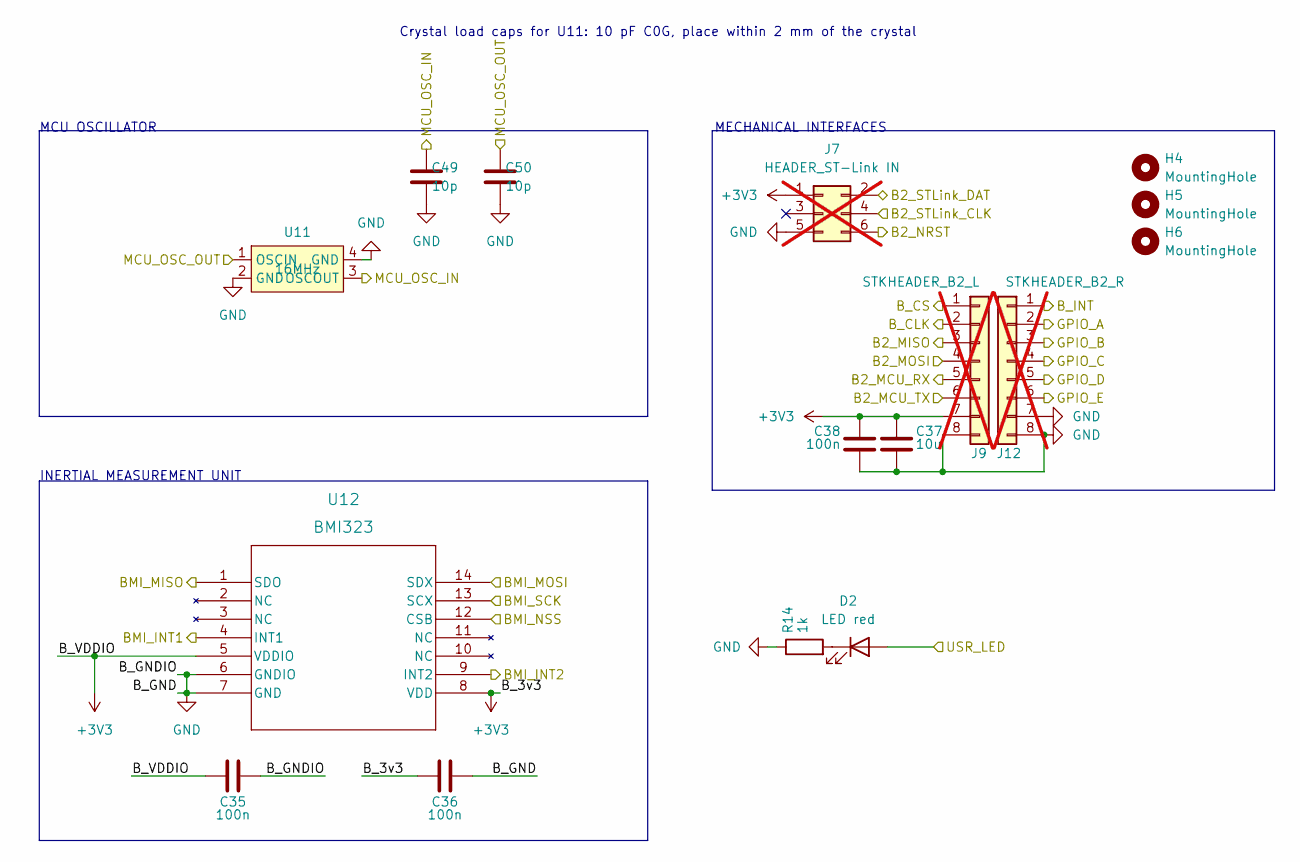
[picture p3: schematic b2.kicad_sch]

Parts:
C35, C36, C38: 100n; C_0603_1608Metric
C37: 10u; C_0603_1608Metric
C49, C50: 10p; C_0603_1608Metric; LCSC C1634
D2: LED red; LED_0805_2012Metric; LCSC C84256
H4, H5, H6: MountingHole; MountingHole_3.2mm_M3
J7: HEADER_ST-Link IN; PinHeader_2x03_P2.54mm_Horizontal; not fitted
J9: STKHEADER_B2_L; PinSocket_1x08_P2.54mm_Vertical; not fitted
J12: STKHEADER_B2_R; PinSocket_1x08_P2.54mm_Vertical; not fitted
R14: 1k; R_0603_1608Metric
U11: 16MHz; Crystal_SMD_3225-4Pin_3.2x2.5mm; MPN YXC X322516MLB4SI; LCSC C13738
U12: BMI323; BMI323_BOS

Connections:
+3V3: C35.1, C36.1, C37.1, C38.1, J7.1, J9.7, U12.5 (VDDIO), U12.8 (VDD); also elsewhere on the board
/B2_CS: J9.1; also elsewhere on the board
/B2_INT: J12.1; also elsewhere on the board
/B2_MCU_RX: J9.5; also elsewhere on the board
/B2_MCU_TX: J9.6; also elsewhere on the board
/B2_NRST: J7.6; also elsewhere on the board
/B2_OSC_IN: C49.1, U11.3 (OSCOUT); also elsewhere on the board
/B2_OSC_OUT: C50.1, U11.1 (OSCIN); also elsewhere on the board
/B2_SWCLK: J7.4; also elsewhere on the board
/B2_SWDIO: J7.2; also elsewhere on the board
/B2_USR_LED: D2.2 (A); also elsewhere on the board
/BMI_CLK: U12.13 (SCX); also elsewhere on the board
/BMI_CS: U12.12 (CSB); also elsewhere on the board
/BMI_INT1: U12.4 (INT1); also elsewhere on the board
/BMI_INT2: U12.9 (INT2); also elsewhere on the board
/BMI_MISO: U12.1 (SDO); also elsewhere on the board
/BMI_MOSI: U12.14 (SDX); also elsewhere on the board
/B_CLK: J9.2; also elsewhere on the board
/B_MISO: J9.4; also elsewhere on the board
/B_MOSI: J9.3; also elsewhere on the board
/GPIOA: J12.2; also elsewhere on the board
/GPIOB: J12.3; also elsewhere on the board
/GPIOC: J12.4; also elsewhere on the board
/GPIOD: J12.5; also elsewhere on the board
/GPIOE: J12.6; also elsewhere on the board
GND: C35.2, C36.2, C37.2, C38.2, C49.2, C50.2, J7.5, J9.8, J12.7, J12.8, R14.1, U11.2 (GND), U11.4 (GND), U12.6 (GNDIO), U12.7 (GND); also elsewhere on the board
unnamed: D2.1 (K), R14.2

Notes on the sheet:
INERTIAL MEASUREMENT UNIT
MCU OSCILLATOR
Crystal load caps for U11: 10 pF C0G, place within 2 mm of the crystal
MECHANICAL INTERFACES

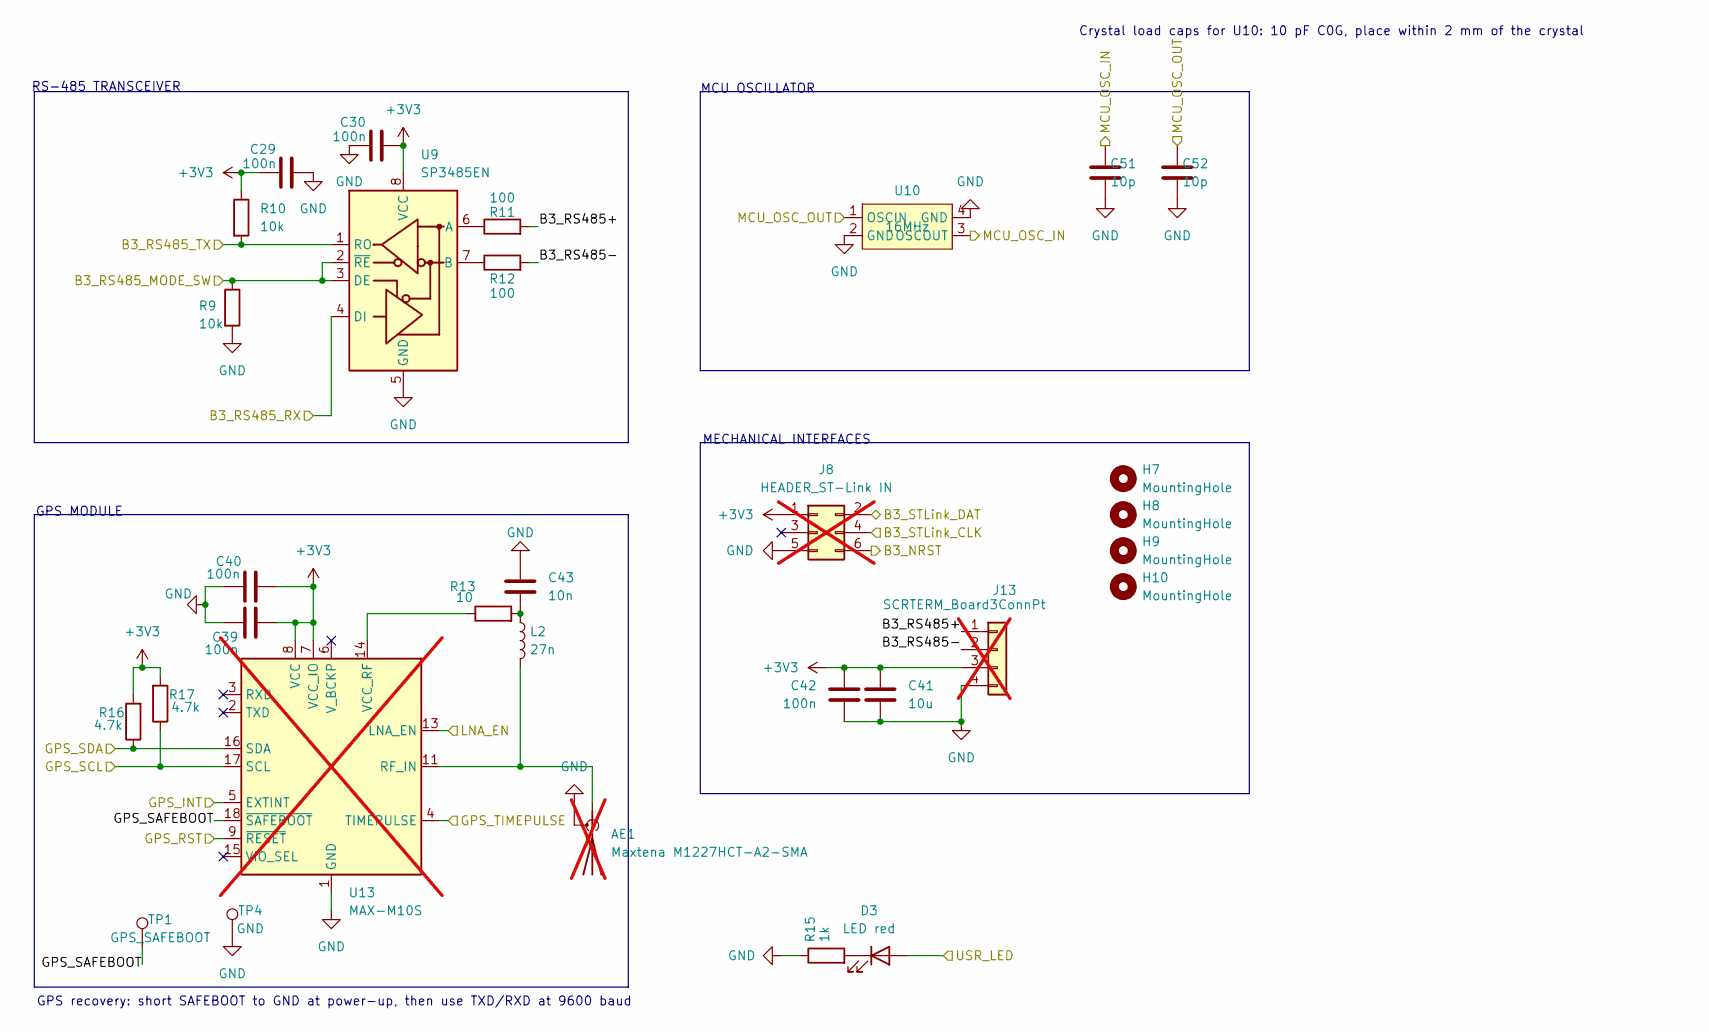
[picture p4: schematic b3.kicad_sch]

Parts:
AE1: Maxtena M1227HCT-A2-SMA; SMA_Amphenol_132289_EdgeMount; not fitted
C29, C30, C39, C40, C42: 100n; C_0603_1608Metric
C41: 10u; C_0603_1608Metric
C43: 10n; C_0603_1608Metric
C51, C52: 10p; C_0603_1608Metric; LCSC C1634
D3: LED red; LED_0805_2012Metric; LCSC C84256
H7, H8, H9, H10: MountingHole; MountingHole_3.2mm_M3
J8: HEADER_ST-Link IN; PinHeader_2x03_P2.54mm_Horizontal; not fitted
J13: SCRTERM_Board3ConnPt; TerminalBlock_Phoenix_MKDS-1-4-3.81_1x04_P3.81mm_Horizontal; not fitted
L2: 27n; L_0603_1608Metric
R9, R10: 10k; R_0603_1608Metric
R11, R12: 100; R_0603_1608Metric
R13: 10; R_0603_1608Metric
R15: 1k; R_0603_1608Metric
R16, R17: 4.7k; R_0603_1608Metric
TP1: GPS_SAFEBOOT; TestPoint_Pad_D1.0mm
TP4: GND; TestPoint_Pad_D1.0mm
U9: SP3485EN; SOIC-8_3.9x4.9mm_P1.27mm; LCSC C8963
U10: 16MHz; Crystal_SMD_3225-4Pin_3.2x2.5mm; MPN YXC X322516MLB4SI; LCSC C13738
U13: MAX-M10S; ublox_MAX; not fitted

Connections:
+3V3: C29.1, C30.2, C39.1, C40.1, C41.1, C42.1, J8.1, J13.3, R10.1, R16.2, R17.2, U9.8 (VCC), U13.7 (VCC_IO), U13.8 (VCC); also elsewhere on the board
/B3_NRST: J8.6; also elsewhere on the board
/B3_OSC_IN: C51.1, U10.3 (OSCOUT); also elsewhere on the board
/B3_OSC_OUT: C52.1, U10.1 (OSCIN); also elsewhere on the board
/B3_RS485_MCU_RX: U9.4 (DI); also elsewhere on the board
/B3_RS485_MCU_TX: R10.2, U9.1 (RO); also elsewhere on the board
/B3_RS485_MODE_SW: R9.1, U9.2 (~RE), U9.3 (DE); also elsewhere on the board
/B3_SWCLK: J8.4; also elsewhere on the board
/B3_SWDIO: J8.2; also elsewhere on the board
/B3_USR_LED: D3.2 (A); also elsewhere on the board
/Board3/B3_RS485+: J13.1, R11.2
/Board3/B3_RS485-: J13.2, R12.2
/Board3/GPS_SAFEBOOT: TP1.1 (1_1), U13.18 (~SAFEBOOT)
/GPS_INT: U13.5 (EXTINT); also elsewhere on the board
/GPS_LNA_EN: U13.13 (LNA_EN); also elsewhere on the board
/GPS_RST: U13.9 (~RESET); also elsewhere on the board
/GPS_SCL: R17.1, U13.17 (SCL); also elsewhere on the board
/GPS_SDA: R16.1, U13.16 (SDA); also elsewhere on the board
/GPS_TIMEPULSE: U13.4 (TIMEPULSE); also elsewhere on the board
GND: AE1.2 (Shield), C29.2, C30.1, C39.2, C40.2, C41.2, C42.2, C43.1, C51.2, C52.2, J8.5, J13.4, R9.2, R15.1, TP4.1 (1_1), U9.5 (GND), U10.2 (GND), U10.4 (GND), U13.1 (GND), U13.10 (GND), U13.12 (GND); also elsewhere on the board
unnamed: AE1.1 (A), L2.2, U13.11 (RF_IN)
unnamed: C43.2, L2.1, R13.2
unnamed: D3.1 (K), R15.2
unnamed: R11.1, U9.6 (A)
unnamed: R12.1, U9.7 (B)
unnamed: R13.1, U13.14 (VCC_RF)

Notes on the sheet:
RS-485 TRANSCEIVER
GPS MODULE
Crystal load caps for U10: 10 pF C0G, place within 2 mm of the crystal
GPS recovery: short SAFEBOOT to GND at power-up, then use TXD/RXD at 9600 baud
MECHANICAL INTERFACES
MCU OSCILLATOR

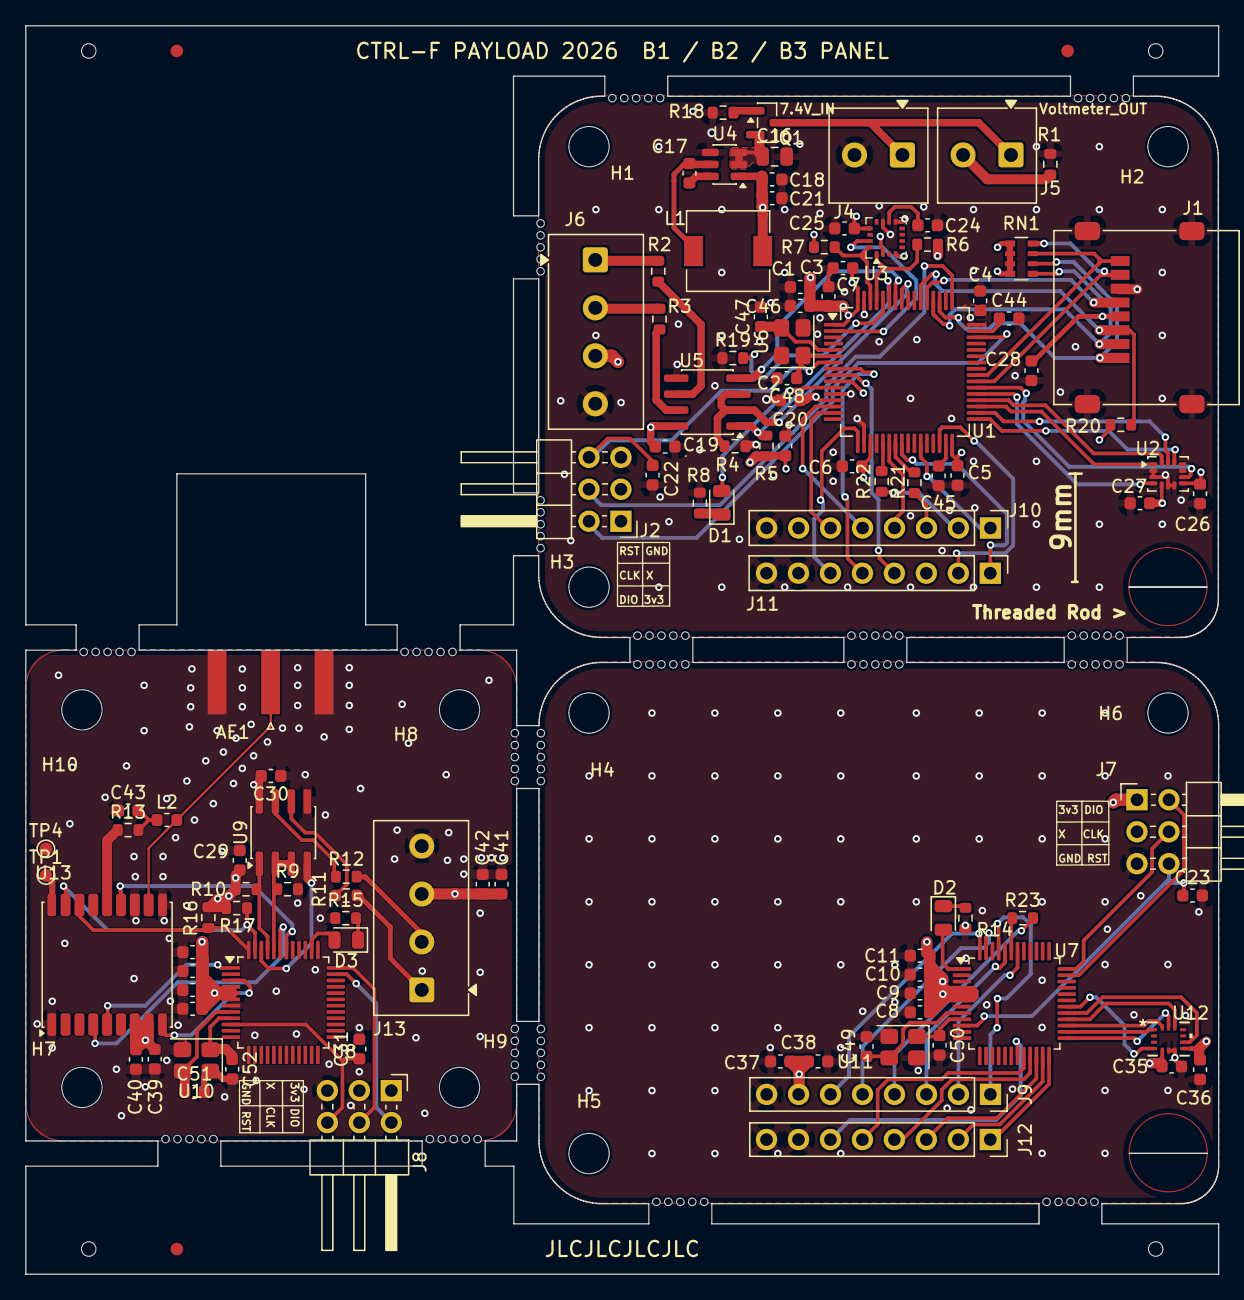
[picture p5: board main.kicad_pcb from above]

Board: 4 copper layers, 94.8 x 99.2 mm, 139 parts (0 on the bottom side), 99 nets.

Other parts of the board:
FID1, FID2, FID3: Fiducial; Fiducial_1mm_Mask2mm
MB1: R-B1a; MouseBite
MB2: R-B1b; MouseBite
MB3: F-B1a; MouseBite
MB4: F-B1b; MouseBite
MB5: B1-B2a; MouseBite
MB6: B1-B2b; MouseBite
MB7: B1-B2c; MouseBite
MB8: B2-Ra; MouseBite
MB9: B2-Rb; MouseBite
MB10: B3-B2a; MouseBite
MB11: B3-B2b; MouseBite
MB12: F-B3a; MouseBite
MB13: F-B3b; MouseBite
MB14: B3-Fa; MouseBite
MB15: B3-Fb; MouseBite
TH1, TH2, TH3, TH4: Tooling; ToolingHole_1.152mm
