AlephInfi/PRISTA/B2_CTRL-F_Payload_2026/B2_CTRL-F_Payload_2026.ioc

Mcu.UserName=STM32G071CBTx
PA13.Signal=SYS_SWDIO
PA14-BOOT0.Signal=SYS_SWCLK
PA8.GPIO_Label=BMI_CS
PA8.Signal=GPIO_Output
PA9.GPIO_Label=BMI_INT2
PA9.Signal=GPIO_Input
PB0.GPIO_Label=E
PB0.Signal=GPIO_Input
PB1.GPIO_Label=D
PB1.Signal=GPIO_Input
PB10.GPIO_Label=B
PB10.Signal=GPIO_Input
PB11.GPIO_Label=A
PB11.Signal=GPIO_Input
PB12.GPIO_Label=B2_INT
PB12.Signal=GPIO_Output
PB13.GPIO_Label=BMI_CLK
PB13.Signal=SPI2_SCK
PB14.GPIO_Label=BMI_MISO
PB14.Signal=SPI2_MISO
PB15.GPIO_Label=BMI_MOSI
PB15.Signal=SPI2_MOSI
PB2.GPIO_Label=C
PB2.Signal=GPIO_Input
PB3.GPIO_Label=B_CLK
PB3.Signal=SPI1_SCK
PB4.GPIO_Label=B_MISO
PB4.Signal=SPI1_MISO
PB5.GPIO_Label=B_MOSI
PB5.Signal=SPI1_MOSI
PB6.GPIO_Label=B_CS
PB6.Signal=GPIO_Input
PB8.GPIO_Label=B2_MCU_RX
PB8.Signal=USART3_TX
PB9.GPIO_Label=B2_MCU_TX
PB9.Signal=USART3_RX
PC13.GPIO_Label=B2_USRLED
PC13.Signal=GPIO_Output
PC6.GPIO_Label=BMI_INT1
PC6.Signal=GPIO_Input
