AlephInfi/PRISTA/(commit log)

2026-10-19 work on dsn checklist
    [b1.kicad_sch, b2.kicad_sch, b3.kicad_sch, main.kicad_pcb, main.kicad_sch]
2026-10-20 continue fixing chklst
    [b1.kicad_sch, b2.kicad_sch, b3.kicad_sch, main.kicad_pcb, main.kicad_sch]
2026-10-28 prep gerber and cpl/bom
    [BOM-main.csv, SW_Timing_Budgets.xlsx, b1.kicad_sch, b2.kicad_sch, b3.kicad_sch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]
2026-10-29 add doc and move SD card VCAP to fit
    [main.kicad_pcb]
